LeonDebonne/TasteMate/README.md

# TasteMate
TasteMate, een slimme koelkastadd-on die het gebruiken van de koelkast vergemakkelijkt voor blinden en slechtzienden. 

🛠️ Built by ``Leon Debonne`` & ``Staf Logie``   
🔥 Supervised by ``prof. dr. Bas Baccarne``, ``Yannick Christiaens`` & ``Wouter Devriese``    
🌱 Grown at ``Ghent University`` 🏛️ ``Industrial Design Engineering`` ([project overview](https://github.com/basbaccarne/human-centered-design))       

*13/06/2026 van de laatste update*   

## Samenvatting
Het efficiënt gebruiken van de koelkast speelt een grote rol in de zelfstandigheid van blinden en slechtzienden. Op dit gebied zijn er, ondanks moderne technologieën nog veel struikelblokken die voor verwarring en frustratie kunnen zorgen. Vooral de samenwerking met zorgkrachten en huisgenoten loopt niet altijd even vlot. Zij weten niet altijd wat er uit de frigo gehaald is of wat juist is aangevuld. Ook de ordening van bepaalde producten in de frigo wordt niet altijd gerespecteerd, waardoor vaak verwarring kan ontstaan. Ten slotte is het bepalen van de houdbaarheidsdata op producten vaak niet evident. Deze problemen werden meerdere malen aangehaald in een online bevraging die verstuurd werd in verschillende Facebookgroepen voor blinden en slechtzienden.

Deze problematiek wensen we aan te pakken met een slimme koelkast-add-on. Deze dient om de samenwerking tussen de verschillende huisgenoten en zorgverleners te bevorderen. Zo kunnen producten in of uit het systeem gehaald worden en worden er vaste plaatsen toegewezen voor elk soort product. Ook worden de houdbaarheidsdata in het systeem bijgehouden. Vervolgens kan men aan een spraakassistent vragen stellen over de inhoud van de koelkast. 
Bv. “Ik heb dorst, wat kan ik drinken?” en “Zijn er producten die bijna over datum gaan?” 

<p align="center">
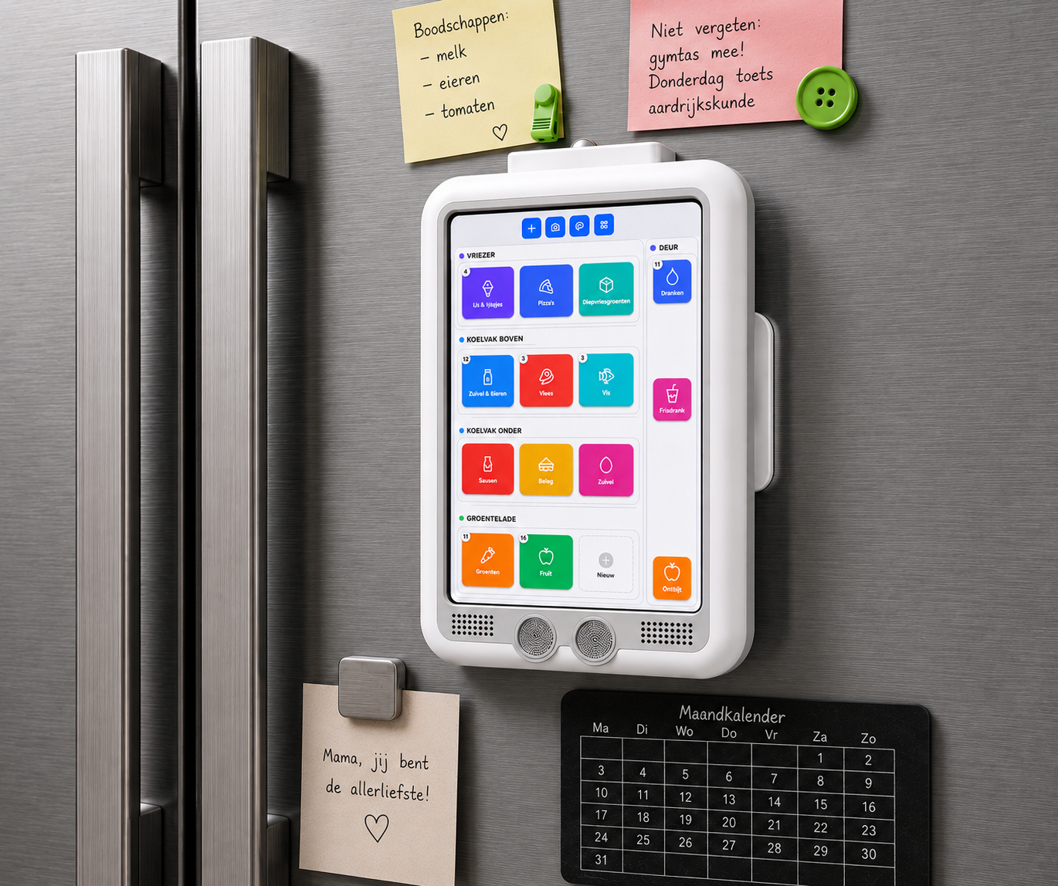
[picture p1: img/Heroshot2.png]
  
</p>

## Introductie
Het efficiënt en zelfstandig gebruiken van huishoudtoestellen is een belangrijke voorwaarde voor autonomie bij blinden en slechtzienden. Toch blijkt het dagelijks gebruik van een koelkast in gedeelde huishoudens vaak problematisch. Moeilijke toegang tot visuele informatie, zoals houdbaarheidsdata en productlabels, gecombineerd met een gebrek aan afstemming met huisgenoten of zorgverleners, leidt regelmatig tot verwarring, voedselverspilling en frustratie. Deze knelpunten kwamen ook duidelijk naar voren in een onlinebevraging binnen verschillende Facebookgroepen voor blinden en slechtzienden.

Dit project situeert zich binnen het domein van assistieve technologie en inclusieve smart home-oplossingen. Het doel is het ontwikkelen van een slimme koelkast add-on die de zelfstandigheid van blinden en slechtzienden ondersteunt en tegelijkertijd de samenwerking binnen het huishouden bevordert. De add-on maakt het mogelijk om producten te registreren, vaste plaatsen toe te wijzen en houdbaarheidsdata bij te houden. Via een spraakassistent kan de gebruiker eenvoudig informatie opvragen over de inhoud van de koelkast, zoals welke dranken beschikbaar zijn of welke producten binnenkort vervallen. Op die manier wordt de cognitieve belasting verminderd en krijgt de gebruiker meer controle over zijn of haar leefomgeving.

“Intelligent applications such as intelligent packaging, intelligent fridges and wider IoT solutions provide opportunities to reduce household food waste.” (Liegeard, J., & Manning, L. 2019)

De oplossing richt zich op zelfstandig wonende blinden en slechtzienden die ondersteund worden door een familielid of professionele begeleider. Belangrijke randvoorwaarden zijn dat het systeem betaalbaar en gebruiksvriendelijk moet zijn. De add-on fungeert nadrukkelijk als ondersteuning en niet als vervanging van menselijke zorg.

[Demonstrator Movie](https://www.youtube.com/watch?v=ily1LTjktjU)

## Inhoudstafel

1. [Methodologie](./docs/methodologie.md)
2. [Discovery](./docs/discovery.md)
3. [Definition](./docs/definition.md)
4. [Develop 1](./docs/develop_1.md)
5. [Develop 2](./docs/develop_2.md)
6. [Develop 3](./docs/develop_3.md)
7. [Conclusie](./docs/conclusie.md)
8. [Design Requirements](./docs/design_requirements.md)
9. [Bill of materials](./docs/bom.md)

## Kritische reflectie

### Semester 1

Het eerste semester stond volledig in het teken van discovery en de eerste definition van ons ontwerpproces.
We startten met een desk research en benchmarking om een beeld te krijgen van wat er vandaag al bestaat. De benchmarks hielpen ons om ons eigen idee te positioneren en niet opnieuw te ontwerpen wat al bestaat, maar eerder te kijken waar het beter of anders kon.

Daarnaast probeerden we via interviews inzicht te krijgen in de ervaringen en noden van blinde en slechtziende gebruikers. Dit bleek aanzienlijk moeilijker dan verwacht. Door hun beperkte beschikbaarheid en het feit dat we zelf weinig directe connecties hadden, was het rekruteren van respondenten een grote uitdaging. Dat was soms frustrerend en zorgde ervoor dat ons onderzoek trager verliep dan gepland.
Toch waren de interviews die we wel konden afnemen zeer waardevol. Ze bevestigden een aantal aannames, maar haalden ook zaken aan die wij zelf niet in vraag hadden gesteld. Dit maakte duidelijk hoe belangrijk het is om niet enkel vanuit eigen perspectief te ontwerpen. De input uit deze gesprekken vormde een sterke basis voor de definition fase en hielp ons om gerichtere ontwerpcriteria op te stellen.

Achteraf gezien was het eerste semester vooral een oefening in geduld en realisme. We leerden dat een goed designproces niet alleen draait om methodes doorlopen, maar ook om mensen vinden, plannen maken en omgaan met beperkingen. Positief is wel dat we intussen al enkele blinde personen hebben kunnen vastleggen voor semester 2. Dat geeft vertrouwen dat we met die mensen verder kunnen en op hun kunnen rekenen.

### Semester 2

Dit semester stond voornamelijk in het teken van de develop-fase, waarbij het concept verder werd uitgewerkt, getest en verfijnd. Tijdens Develop 1 en Develop 2 lag de focus op het realiseren van een Minimum Viable Product (MVP). Hierbij wilden we aantonen dat gebruikers op een toegankelijke manier correcte informatie uit het systeem konden opvragen, zoals de inhoud van de koelkast, houdbaarheidsdata en de locatie van producten.

Tijdens de ontwikkeling merkten we echter dat het volledig automatiseren van het invoeren en beheren van productdata veel complexer was dan oorspronkelijk verwacht. Hoewel dit conceptueel uitgebreid werd onderzocht en besproken in eerdere fases, bleek de technische realisatie binnen de beschikbare tijd en middelen niet haalbaar. Daarom werd ervoor gekozen om de nadruk te leggen op het valideren van onze MVP.

Daarnaast werd ook de volledige elektronica uitgewerkt en getest. Bij de verdere integratie in het product botsten we echter op beperkingen van de beschikbare hardware, zoals de afmetingen van het scherm. Hierdoor konden we de elektronica niet volledig verwerken in het finale prototype zoals oorspronkelijk voorzien. Om toch een realistisch beeld van het eindproduct te geven, werd een mock-up ontwikkeld waarin de vormgeving, uitstraling en CMF-keuzes duidelijk zichtbaar werden gemaakt.

De feedback die we ontvingen van de burgerlijk ingenieurs was waardevol en bracht bijkomende aandachtspunten aan het licht. Zo werd onder andere gesuggereerd om extra aandacht te besteden aan het vervangen of opladen van de batterij, aangezien dit voor blinde gebruikers een belangrijk aspect van de gebruikservaring kan zijn. Deze feedback werd pas in een latere fase van het project ontvangen, waardoor er nog beperkt ruimte was om hier grondig op verder te werken. Desondanks vormt dit een waardevol inzicht dat bij een verdere ontwikkeling van het concept zeker verder onderzocht en uitgewerkt zou worden.

Terugkijkend heeft dit semester aangetoond dat er vaak een verschil bestaat tussen een conceptuele oplossing en een technisch realiseerbaar product. Door duidelijke keuzes te maken en te focussen op de belangrijkste functionaliteiten konden we toch een concept ontwikkelen dat de meerwaarde van TasteMate aantoont en tegelijk waardevolle inzichten opleverde voor verdere ontwikkeling.

## Noot inzake het gebruik van AI
AI werd gebruikt om onze tekststructuur te verbeteren en ons taalgebruik te finetunen. Ook werd dit voor een groot deel gebruikt tijdens het coderen. Dit om te helpen op stukken waar wij vastlopen. Als laatst werd de render ook met AI gemaakt.

## Bijlagen
### Discovery
* Enquête Facebookgroepen (N=22)
  * [Protocol](https://docs.google.com/document/d/1o7BqGVpPXtm0b7tqXvRCuAdfVG6ncJB_/edit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)
  * [Rapport](https://docs.google.com/document/d/1O7acjI5cb6R5L7ywIF9YDT1ZCcgL2F2K/edit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)
* Benchmarking (N=10)
  * [Protocol](https://docs.google.com/document/d/1vpAEKPRMlF7svy2KSTlp5V-UzUufb8lO/edit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)
  * [Rapport](https://docs.google.com/document/d/19CgoGhrFplItanu5dZs29OpG1R62N-Oo/edit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)
* Interviews (N=3)
  * [Protocol](https://docs.google.com/document/d/1DkY7SQlU1YFRJ9Iaqg9hwLcdLrmlHHz3/edit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)
  * [Rapport](https://docs.google.com/document/d/1aK8kBRMgLxHuCd8vMiPDScQNG72IshPE/edit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)
    
### Definition
* User testing wave 1 (N=2)
  * [Protocol](https://docs.google.com/document/d/17SA_GU3ZMbyh3iPbD7dw8ONl4re0EuEN/edit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)
  * [Rapport](https://docs.google.com/document/d/1uVGif4huSNOTb77L3XkXnCsxwViHGHP_/edit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)
* User testing wave 2 (N=3)
  * [Protocol](https://docs.google.com/document/d/1HitaRYjg1pTKpnl82D7k5fCMe0rHJzY5/edit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)
  * [Rapport](https://docs.google.com/document/d/1aru_T9R6SH-N8Gx5HF_E67F5_VzKGTME/edit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)

### Develop 1
* Concept test bevestiging (N=3)
  * [Protocol](https://docs.google.com/document/d/e/2PACX-1vQ5ILdNGkCSPqVTiytStXOEiOJM4TjMdFCXSKQb1augADyw9BpXbAz7HJRe_mXLuvI6zYdc-TxWrjU1/pub)
  * [Rapport](https://docs.google.com/document/d/e/2PACX-1vR47XYeArb4eWIysHD9ILE3gX5S1hcfoUbw3N7H9VU58sae2Dqq3-ShSmpNV-UUnw9ESvzIbVZow18U/pub)
* Expert interviews (N=3)
  * [Protocol](https://docs.google.com/document/d/e/2PACX-1vT5qwDmTJz31Pu7O_5GgxLXhZHN01odxg5vEh5BfgYlWgnNDJRftLWxD9k230-aiaKeoALtmhIkP-6a/pub)
  * [Rapport](https://docs.google.com/document/d/e/2PACX-1vSvRK79bp2z6k5HUvx2PvZjFKIwNcD5ZVd11kHikQGJ9xtiXwY7O45dNws0hmYpW2Lt67I7f6oeh9VG/pub)

### Develop 2
* User test (N=4)
  * [Protocol](https://docs.google.com/document/d/e/2PACX-1vSZAIsG-67mNmNAeyc7hR0xE32fgY2YTjmxxFuSa4Wrfsae-_UYOLSROmIYCnQvqXG1CrvmCIasRkVt/pub)
  * [Rapport](https://docs.google.com/document/d/e/2PACX-1vSd7Mb4eXCC1kvDG9D2kJRvHZshqICP1pkpbPtWgAk5q2GEnKnOpCg0xRPsQOpQLasvUqzuRUvRHjwG/pub)

### Develop 3
* User test (N=6)
  * [Protocol](https://docs.google.com/document/d/1Du3yc0JP2OO7tfJ1TO66lZ7buom-ocno/edit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)
  * [Rapport](https://docs.google.com/document/d/1h7tK0cSN0zwXzeMT8oHGi7Mp2MEAxwit/edit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)

## Licentie 
This repository contains both software and design materials created as part of an industrial design energineering project at Ghent University.

- **Software and code:** [MIT License](./LICENSE-MIT)  
- **Design, documentation, CAD, and media:** [CC BY 4.0 License](./LICENSE)
  
You are free to reuse and build upon this work, both commercially and non-commercially, as long as proper attribution is given to the original authors.

## Bronnen
Liegeard, J., & Manning, L. (2019). Use of intelligent applications to reduce household food waste. Critical Reviews in Food Science and Nutrition, 60(6), 1048–1061.

## Bijlages
* [Figma](https://www.figma.com/board/59k548JUTl15b52AJoe5UV/TasteMate?node-id=10-61&t=lsChgVIFU8SK2wAH-1)
* [Vizcom](https://app.vizcom.com/workbench/dc0de77b-4444-438e-a90e-edc5628e1e74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)
* [Figma Interface](https://www.figma.com/make/pgeZag6MNCPOQKma9MVNmQ/Koelkast-inventaris-interface?t=HiBIRN7gsiTSVexH-1)
