LeonDebonne/TasteMate/docs/methodologie.md

## Methodologie
In dit project werd gewerkt volgens het "Triple Diamond"-ontwerpproces. Dit model bestaat uit drie hoofdfases: Discover, Define en Develop. Deze fases dienen als leidraad gedurende het project. In het eerste semester worden de eerste twee fases doorlopen.

De eerste fase is de Discover-fase en vindt plaats tijdens de eerste zes weken van het semester. In deze fase is het doel om zich te oriënteren binnen het project en een probleem te identificeren dat aansluit bij de design challenge. Dit gebeurt aanvankelijk individueel. Het probleem wordt onderzocht via verschillende methodes. Eerst wordt een literatuurstudie en benchmarking uitgevoerd, waarna op basis van deze inzichten interviews met experts worden afgenomen. Aan het einde van deze fase wordt een concept pitch gehouden, waarbij een jury beslist welke projecten verder worden uitgewerkt.

De Define-fase vindt plaats tijdens de laatste zes weken van het semester. In deze fase is het doel om het concept te valideren. Dit gebeurt door het maken van ‘quick-and-dirty’ prototypes, die worden uitgewerkt in verschillende waves. Het testen van verschillende interfaces speelt hierbij een belangrijke rol. Na meerdere iteraties van de prototypes en interfaces worden gebruikerstesten uitgevoerd, aanvankelijk in de vorm van klassieke interviews. Hierbij worden gerichte vragen gesteld over de prototypes. Op basis van deze feedback wordt verder gewerkt aan wave 2. Vervolgens worden opnieuw gebruikerstesten uitgevoerd op het aangepaste prototype, ditmaal via "Thinking aloud"-testing. Als resultaat van deze testen wordt het concept verder aangescherpt en worden mogelijke ontwerpfouten weggewerkt. Uiteindelijk ontstaat er een lijst met design requirements die als fundament dient voor de volgende fases.

Hierna volgt de Develop-fase. Deze wordt opgedeeld in drie kleinere fasen, elk met hun eigen doelstellingen. Aan het einde van de Develop-fase is het de bedoeling om tot een finaal ontwerp te komen.

In het eerste onderdeel, namelijk Develop 1, evolueert het concept naar een onderbouwde functionele architectuur. Hierbij worden verschillende structuren en modellen aangemaakt om meer inzicht in het product te verkrijgen. Daarnaast vindt een concepttest plaats om enkele ontwerpkeuzes te onderbouwen. Tot slot nemen we interviews af om de noden en eisen van de gebruiker te valideren.

Het tweede deel van de Develop-fase draait vooral rond het antropometrische aspect van het product. De usability van de gemaakte interface wordt hier ook op de proef gesteld. De gebruiker wordt opgemeten en getest op verschillende vaardigheden met de interface. Als laatste wordt de system usability scale [SUS](https://en.wikipedia.org/wiki/System_usability_scale) ingevuld.

Het derde en laatste deel van deze fase focust zich op de CMF(Color, Material, Finishes) van het product. Verder wordt het emotioneel afspect achter deze pijlers onderzocht. Door vele prototype varianten te maken en deze af te wegen ten opzicht van elkaar tijdens gebruikerstesten ontstaat er een verfijnd product. Tijdens de testen wordt het Thinking-Aloud protocol toegepast. Een hulpmiddelen tijdens deze testen is een morfologische CMF-matrix. Hiervan worden de opties beoordeelt via een evaluatievragenlijst om de voorkeuren te kwantificeren. Na deze fase kan er volop gewerkt worden aan het finale product.

Ten slotte volgt de Delivery-fase. Hierin wordt het project afgewerkt en de demonstrator movie gemonteerd.

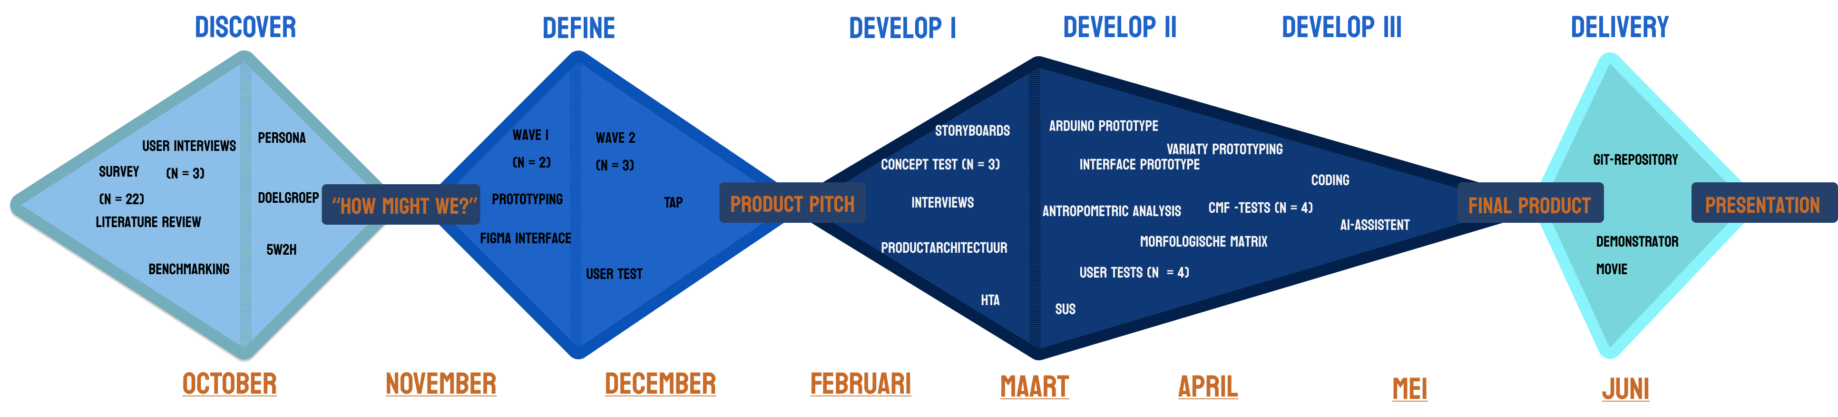
[picture p2: img/Group2.png]
TripleDiamondSem2
