LeonDebonne/TasteMate/docs/definition.md

## Definition

### Doestellingen
In deze fase van het onderzoek is het de bedoeling om van het gekozen probleem in de Discovery-fase een concreet concept te maken en dit te valideren. Het hoofddoel is het probleem beter af bakenen en dieper onderzoek voeren naar de noden en eisen van de gebruikers. Volgende onderdelen werden specifiek bestudeerd.

-	Het gebruik van de koelkast in het dagelijkse leven van een visueel beperkte persoon en de problemen in dit proces.
-	De interacties tussen het concept en de gebruiker.

### Materiaal & methoden

De definition fase begon met een sprint-dag. Hier werden enkele ontwerpeisen opgesteld als inzichten van de Discovery-fase. Uit deze eisen vloeide een storyboard die het proces van het gebruik van de koelkast met ons concept voorstelt.

<p align="center">
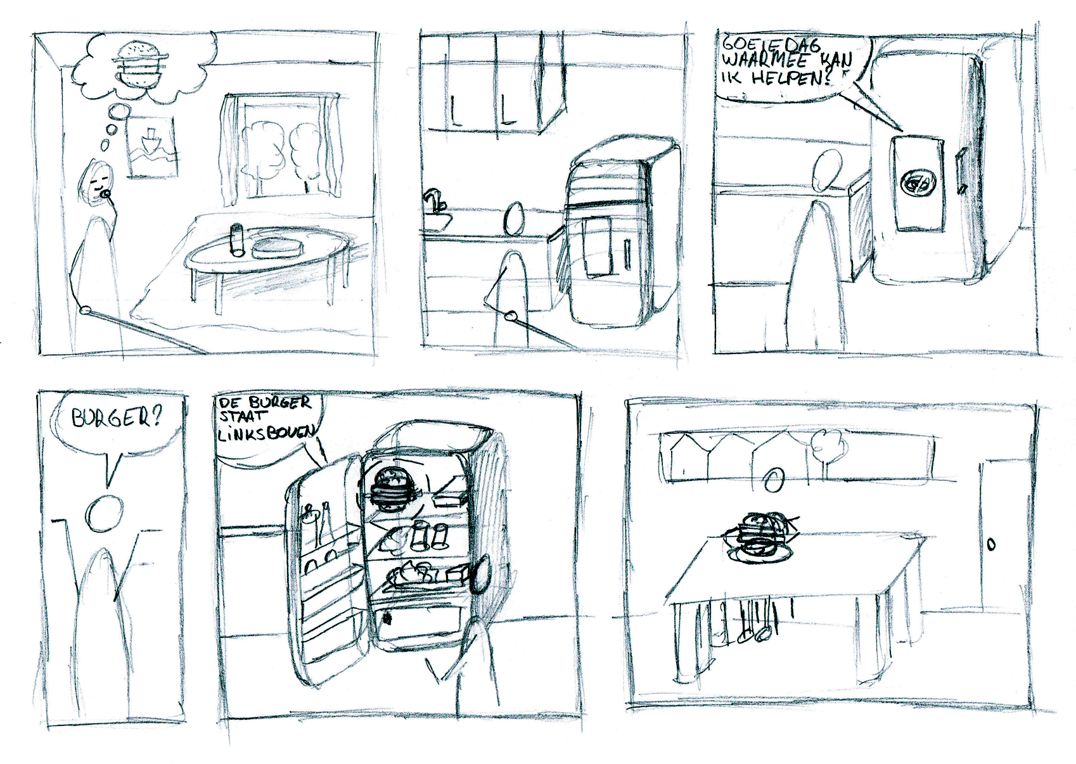
[picture p3: img/Storyboard.jpg]


Om het concept concreter te maken werd er gewerkt aan de hand van 2 prototyping waves die elke verschillende aspect onderzochten. In deze waves werden prototypes gemaakt en deze werden aan de hand van interviews en gebruikstesten beoordeeld. Op voorhand van deze testen werden er steeds protocollen opgesteld om zo gestructureerd te werk te kunnen gaan.

#### WAVE 1 
In wave 1 werd er verder onderzoek gedaan naar de vormgeving van het concept. Dit werd gedaan via 3 verschillende quick-and-dirty prototypes uit karton. Door deze prototypes voor te leggen zonder randinformatie aan visueel beperkte personen en mensen in hun omgeving werden er verschillende inzichten verworven rond de vormgeving. De prototypes werden besproken door de testpersonen via een semigestructureerd interview. Via deze manier ontstond er spontante feedback zonder filter.

<p align="center">
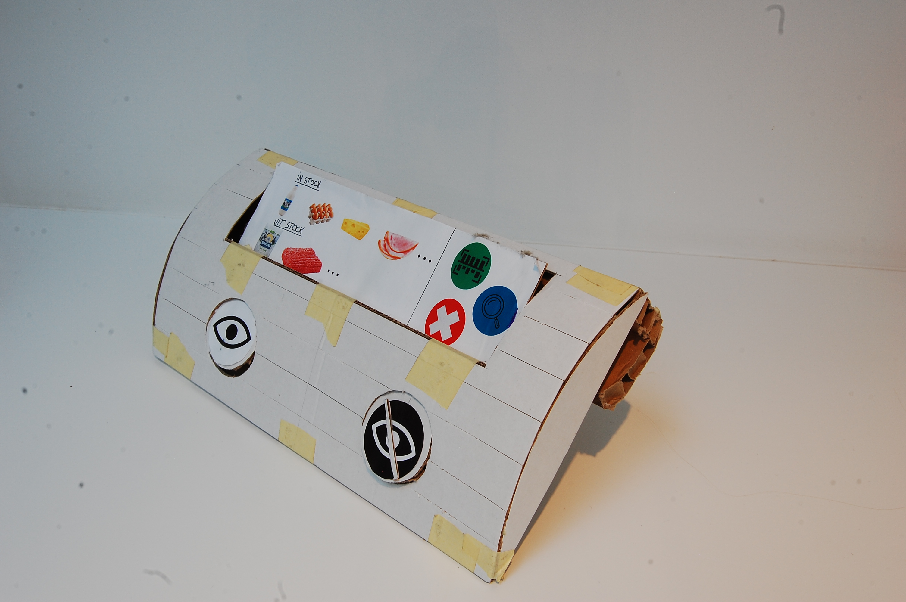
[picture p4: img/Prototype1.JPG]

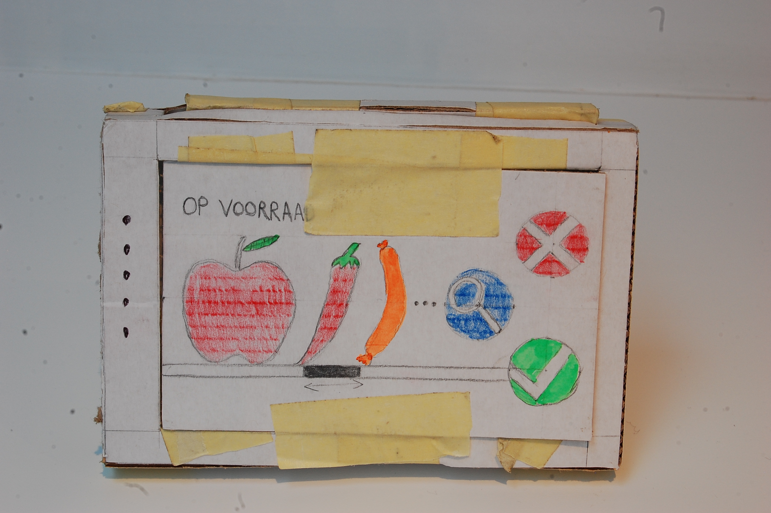
[picture p5: img/Prototype2.JPG]

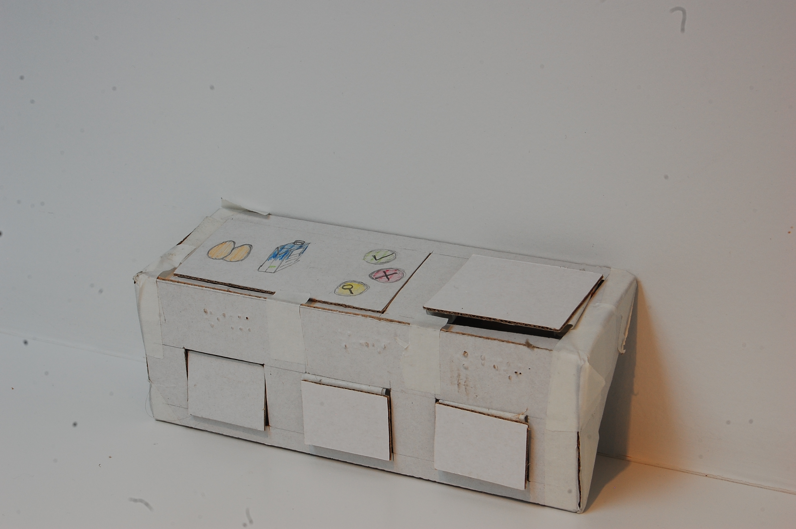
[picture p6: img/Prototype3.JPG]

</p>

De kennis en inzichten uit deze wave werden dan meegenomen om het fysiek prototype te maken voor de testen van wave 2.

#### WAVE 2
Het doel van wave 2 is om onderzoek te voeren naar de interface van het ontwerp en de functies hiervan. Om dit voorstelbaar te maken werden er twee interfaces gemaakt via FigmaMake. Door de gebruiker vrij met de prototypes te laten werken werd er gekeken hoe de doorsnee gebruiker gebruik maakt van de interface.

<p align="left">
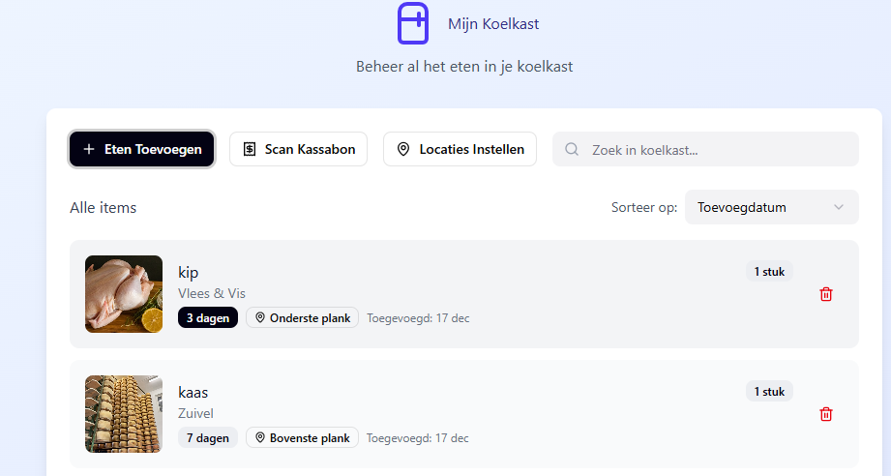
[picture p7: img/Interface1.png]

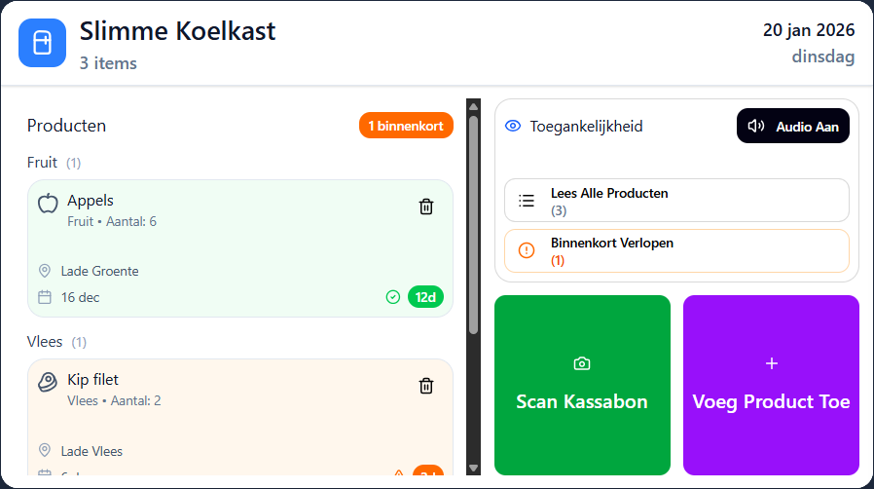
[picture p8: img/Interface2.png]

<p align="center">
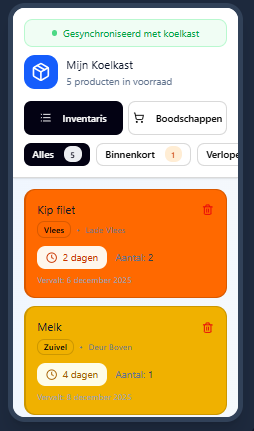
[picture p9: img/InterfaceGSM.png]

</p>

Na de testen in iedere wave werd er rapportering opgesteld om op terug te vallen tijdens volgende fases. Deze bevatten geanalyseerde feedback en observaties die samengevat worden. 

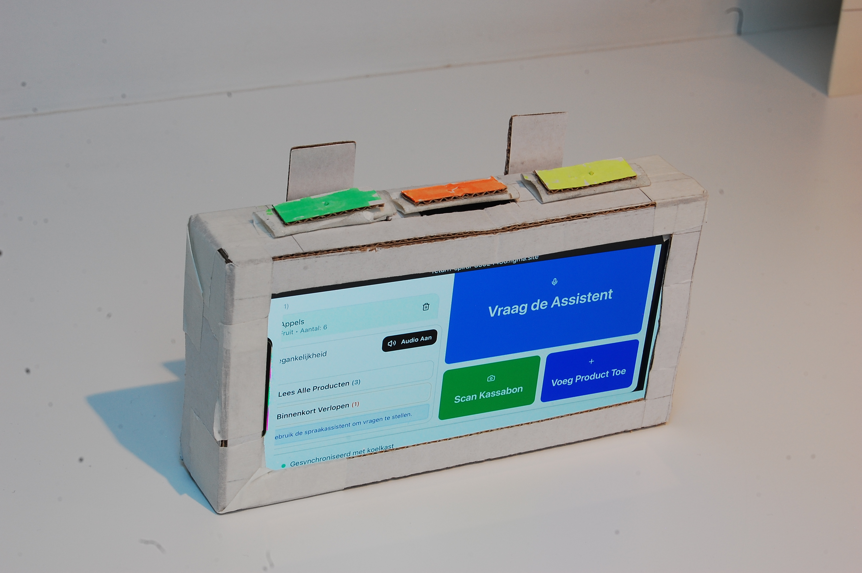
[picture p10: img/PrototypeWave2.JPG]
PrototypeWave2


### Resultaten

#### WAVE 1 (N = 2) 

De drie prototypes werden voorgelegd en besproken door onze respondenten.  Ook werd er al eens een preview getoond van de interface om ook hierrond snelle feedback te verwerven. 

**Prototype 1 :** Het eerste prototype viel vooral in de smaak door de grote hiervan. Voor visueel beperkte personen is het veel gemakkelijker om met grotere objecten te werken. De functie die het mogelijk maakt om te kiezen welke interface gebruikt wordt bleek overbodig. Beginnen spreken tegen het product of het scherm aanraken zouden eenvoudiger zijn om de interactie met het product te initiëren.

**Prototype 2 :** De vorm van het prototype werd positief ontvangen. Het feit dat het scherm kan uitklappen naast de koelkast zodat het concept kan gebruikt worden met een open en een dichte koelkast was ook een belangrijk pluspunt. Het product mocht echter wel groter. De slechtziende testpersoon vond dat het te uitdagend om vlot met het prototype te werken. Er werd wel opgemerkt dat de grootte voor blinden minder een barrière vormt. 

**Prototype 3 :**  De vorm van dit prototype was onhandig om te gebruiken doordat, de knoppen die gebruikt worden door de visueel beperkte personen aan de onderkant van de geometrie bevinden. De braille die te vinden was op deze knoppen beviel wel goed. Commentaar hierop was dat dit niet per se braille moet zijn maar, dat het tactiele van de knoppen het belangrijkste is.

<p align="left">
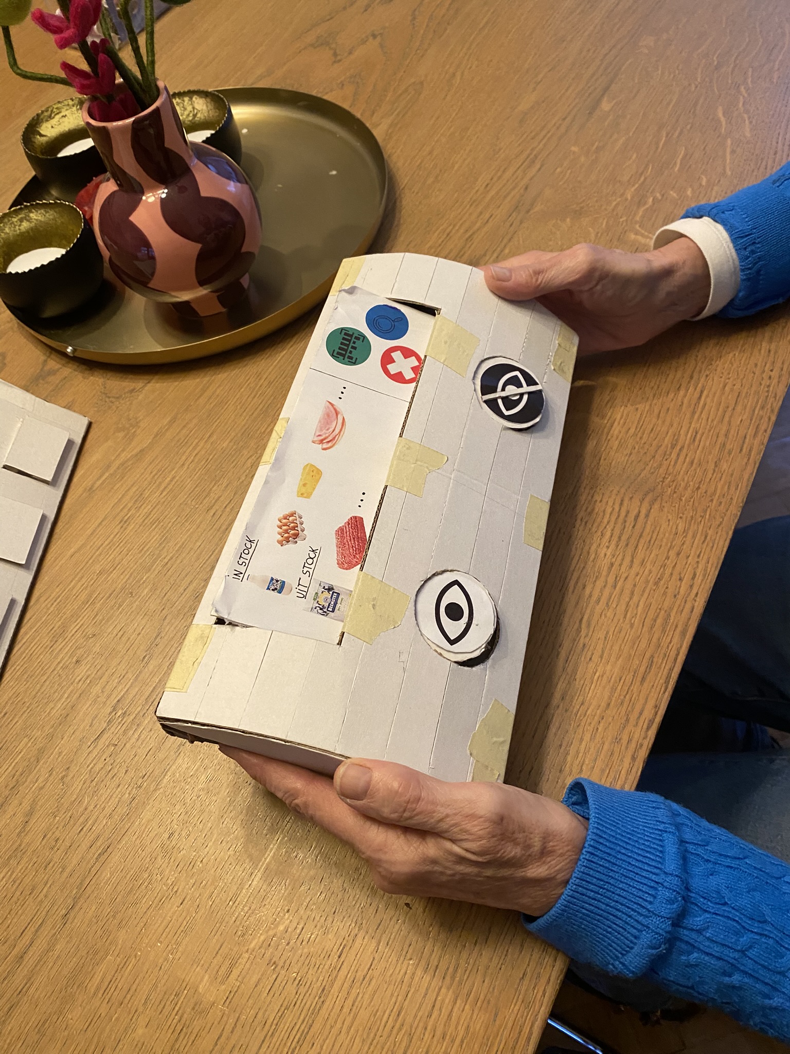
[picture p11: img/FotoPrototype2.JPEG]

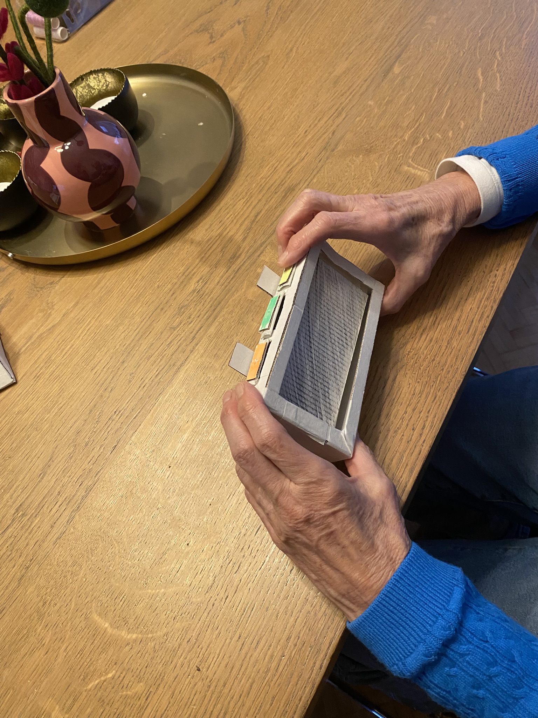
[picture p12: img/FotoPrototype3.JPEG]

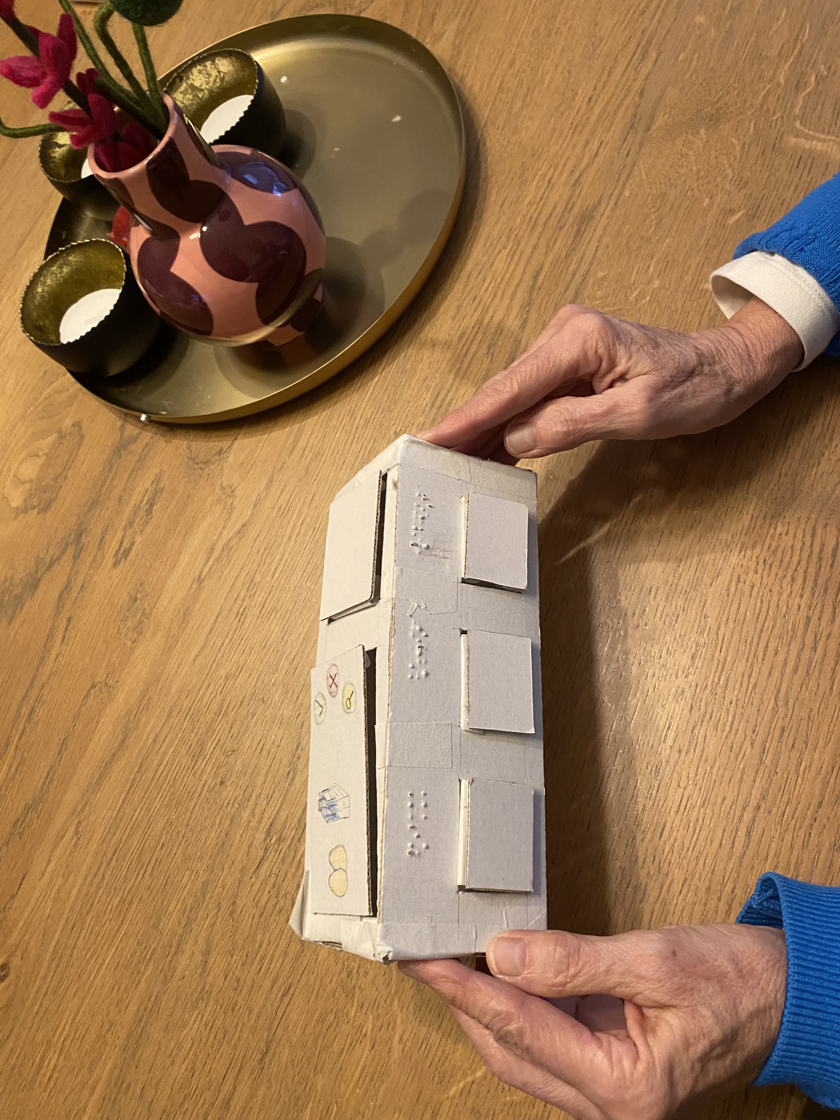
[picture p13: img/FotoPrototype1.JPEG]


Deze feedback werd geanalyseerd en in een scorematrix gegoten. Zo zijn de beste aspecten van ieder prototype bijgehouden.
<p align="center">
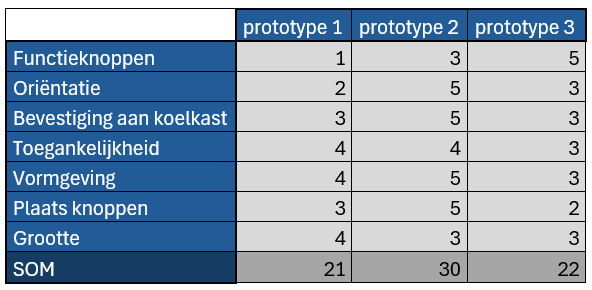
[picture p14: img/Tabel Analyse wave1.png]


Na meer duiding te geven rondom het project werd er ook op gewezen dat een app die gesynchroniseerd is met de slimme koelkast ook van pas kan komen. Het opstellen van boodschappenlijstjes voor visueel beperkte mensen is vaak een drempel. Een app die de inventaris bij houdt is praktischer. Ook is het essentieel dat het product op verschillende koelkasten past.

>[!IMPORTANT] 
> Design Requirements:
> - D2.2 Het systeem moet gebruikt kunnen worden als de koelkast geopend is, maar ook als deze gesloten is.
> - D2.6 Het ontwerp moet gebruiksvriendelijk zijn voor zowel de visueel beperkte gebruiker als huisgenoten/zorgverleners.
> - D2.8 De add-on moet compatibel zijn met bestaande koelkasten en geen ingrijpende aanpassingen vereisen.

#### WAVE 2 (N = 3):
De FigmaMake interfaces werden na een korte voorstelling van het project getest en besproken. Voor de meeste testpersonen was de werkingswijze van de interfaces intuïtief. 

**Interface 1 :** De lay-out van de interface bleek efficiënt en eenvoudig voor doorsnee gebruikers. De grootte van de tekst en functieknoppen op het scherm was te klein als slechtziende personen dit ook zouden willen gebruiken. Een functie die overbodig bleek te zijn voor visueel beperkte personen was de locatie van de voeding die werd voorgelezen door de AI -assistent doordat dit op vast locaties ligt. Bij het toevoegen van een kassabon werd er gevraagd om een pop-up toe te voegen die samenvat welke producten er gescand zijn. Zo kunnen foutieve producten gefilterd worden op voorhand.

**Interface 2 :** De interacties tussen de gebruikspersonen en de AI-assistent verliepen zeer vlot. Het kleurrijke design van de interface viel tegen volgens de testpersonen, het deed tekort aan professionaliteit. Het opzoeken van verschillende producten bleek handig om de inventaris te checken. De app die synchroon met de koelkast werkt werd goed ontvangen. Echter ontbrak een boodschappenlijstje die automatisch gemaakt werd.

>[!IMPORTANT] 
> Design Requirements:
> - D2.5 De gebruiker moet via een spraakassistent vragen kunnen stellen over de inhoud van de koelkast.
> - D2.9 Het systeem moet efficiënt de inhoud kunnen aanpassen, zodat mensen niet opgeven met het product te gebruiken.
> - D2.10 Het systeem moet helpen bij het bevorden van zelfstandig boodschappen doen.

### Conclusies & implicaties

De conclusies uit de eerste wave zijn dat het product groot genoeg moet zijn als slechtziende personen willen werken met de interface op het scherm. De functieknoppen moeten een tactiel element hebben voor snelle herkenning. Het product moet bruikbaar zijn bij een gesloten en open koelkast.

De knop voor de AI-assistent moet groot en herkenbaar zijn.
Voor wave 2 zijn de belangrijkste punten dat het niet te ingewikkeld moet. De knoppen die gebruikt worden door de visueel beperkte personen mogen niet op het scherm. Het automatisch aanmaken van een boodschappenlijst mag zeker niet ontbreken. Het moet ook mogelijk zijn op specifieke producten op te zoeken. Het scannen van een kassabon is ook een vereiste zodat het niet veel tijd kost om de inventaris aan te passen.

>[!IMPORTANT] 
> Design Requirements:
> - D2.1 Het systeem moet producten kunnen registreren wanneer deze in of uit de koelkast worden geplaatst.
> - D2.3 Het systeem moet vaste plaatsen in de koelkast kunnen toewijzen aan productcategorieën.
> - D2.4 Het systeem moet houdbaarheidsdata digitaal bijhouden en hierover tijdig feedback geven.
> - D2.7 Het product moet privacyvriendelijk omgaan met persoonlijke en huishoudelijke gegevens.

Deze conclusie werden bepaald via een MoSCoW-analyse.
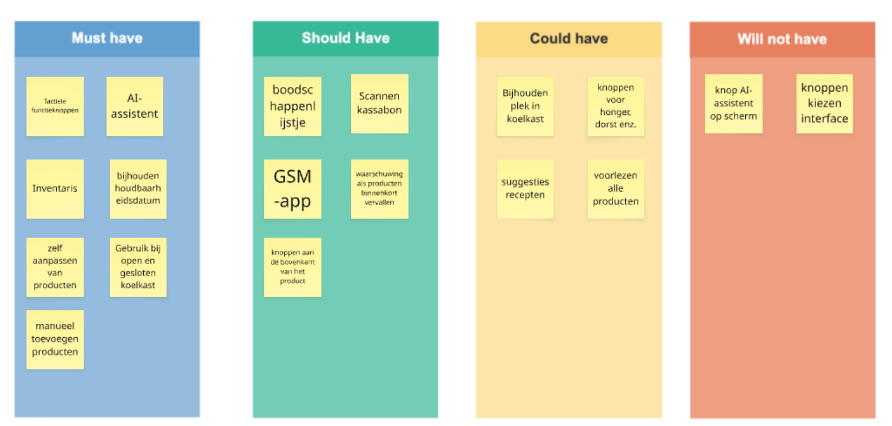
[picture p15: img/MoSCoW-analyse.png]
Moscow
