LeonDebonne/TasteMate/docs/design_requirements.md

## Overzicht van Design Requirements
|| **Status** || ❌ niet voldaan || ⚠️ gedeeltelijk voldaan || ✅ voldaan ||
|ID|Design Requirement|Source|Status|
|:---|:---|:---|:---:|
|**Discover**|
|1.1|De oplossing ondersteunt de zelfstandigheid van blinden en slechtzienden bij het dagelijks gebruik van de koelkast.|[Discovery](discovery.md)|✅|
|1.2|De oplossing minimaliseert verwarring en frustratie bij wijzigingen in de koelkastinhoud door derden.|[Discovery](discovery.md)|✅|
|1.3|De oplossing faciliteert samenwerking en communicatie tussen de gebruiker, huisgenoten en zorgverleners.|[Discovery](discovery.md)|✅|
|1.4|De oplossing biedt een actueel overzicht van de aanwezige producten in de koelkast.|[Discovery](discovery.md)|✅|
|1.5|De oplossing biedt toegankelijke en betrouwbare informatie over houdbaarheidsdata.|[Discovery](discovery.md)|✅|
|1.6|De interactie verloopt primair auditief en intuïtief, waardoor visuele input optioneel is.|[Discovery](discovery.md)|✅|
|1.7|De oplossing is laagdrempelig en bruikbaar zonder complexe handelingen of technische voorkennis.|[Discovery](discovery.md)|✅|
|1.8|De oplossing fungeert als ondersteuning en bevordert de bestaande zorgverlening.|[Discovery](discovery.md)|✅|
|1.9|Het product is financieel toegankelijk voor thuisgebruik.|[Discovery](discovery.md)|❌
|**Definition**|
|2.1|Het systeem registreert producten bij het plaatsen in of uitnemen uit de koelkast.|[Definition Wave 1&2](definition.md)|✅|
|2.2|Het systeem is functioneel bij zowel een geopende als gesloten koelkastdeur.|[Definition Wave 2](definition.md)|✅|
|2.3|Het systeem wijst vaste locaties in de koelkast toe aan specifieke productcategorieën.|[Definition Wave 2](definition.md)|✅|
|2.4|Het systeem monitort houdbaarheidsdata digitaal en geeft tijdige feedback.|[Definition Wave 1](definition.md)|✅|
|2.5|De koelkastinhoud is opvraagbaar via een spraakassistent.|[Definition Wave 1&2](definition.md)|✅|
|2.6|Het ontwerp is gebruiksvriendelijk voor zowel visueel beperkte gebruikers als huisgenoten en zorgverleners.|[Definition Wave 1&2](definition.md)|✅|
|2.7|Het product waarborgt de privacy van persoonlijke en huishoudelijke gegevens.|[Definition Wave 2](definition.md)|✅|
|2.8|De add-on is compatibel met bestaande koelkasten zonder ingrijpende aanpassingen.|[Definition Wave 1](definition.md)|✅||
|2.9|Het systeem staat een efficiënte aanpassing van de inhoud toe om de gebruikersretentie te maximaliseren.|[Definition Wave 2](definition.md)|✅|
|2.10|Het systeem bevordert de zelfstandigheid bij het doen van boodschappen.|[Definition Wave 2](definition.md)|⚠️|
|**Develop 1**|
|3.1|Het systeem laat toe kleurencontrast aan te passen naar persoonlijke voorkeur gebruiker.|[Develop 1](develop_1.md)|✅|
|3.2|Het systeem is bruikbaar met courante schermleessoftware.|[Develop 1](develop_1.md)|❌|
|**Develop 2**|
|4.1| Het product volgt het principe voor design for adjustability|[Develop 2](develop_2.md)|✅|
|4.2| Kritieke acties (zoals verwijderen) vereisen een duidelijke maar niet storende bevestiging om fouten te vermijden. |[Develop 2](develop_2.md)|✅|
|4.3| Het systeem vereist minimale fysieke inspanning bij het aanpassen van positie (lage weerstand, intuïtieve scharnieren). |[Develop 2](develop_2.md)|✅|
|4.4| Alle iconen op de interface zijn eenduidig en semantisch herkenbaar zonder uitleg. |[Develop 2](develop_2.md)|✅|
|4.5| Het systeem bevat consistentie en visuele hiërarchie volgens Gestalt-principes. |[Develop 2](develop_2.md)|✅|
|4.6| Navigatie door het systeem vereist geen voorafgaande training of uitleg. |[Develop 2](develop_2.md)|✅|
|4.7| De interface moet een SUS-score > 80 behalen. |[Develop 2](develop_2.md)|✅|
|**Develop 3**|
|5.1|De behuizing is vervaardigd uit kwaliteitsvolle kunststof met voldoende wanddikte om een gevoel van stevigheid en duurzaamheid te geven.|[Develop 3](develop_3.md)|✅|
|5.2|Het product heeft een neutraal kleurenpalet (bij voorkeur zwart of wit) om te integreren in diverse keukenomgevingen zonder de aandacht te trekken.|[Develop 3](develop_3.md)|✅|
|5.3|De afwerking is mat om lichtreflectie te vermijden en rust en professionaliteit uit te stralen.|[Develop 3](develop_3.md)|✅|
|5.4|De behuizing heeft afgeronde hoeken voor een moderne en kwaliteitsvolle esthetiek.|[Develop 3](develop_3.md)|✅|
|5.5|Het tactiele knopelement is groot en duidelijk herkenbaar zonder visuele controle.|[Develop 3](develop_3.md)|✅|
|5.6|Het product vermijdt textuur of opvallende oppervlaktedetails die de aandacht afleiden of storend kunnen zijn voor visueel beperkte gebruikers.|[Develop 3](develop_3.md)|✅|
