LeonDebonne/TasteMate/docs/develop_3.md

## Develop 3

In deze deelopdracht wordt gefocust op de CMF-analyse (Colour, Material & Finish) van het product. Aan de hand van gebruikstesten met verschillende prototypevarianten worden ontwerpbeslissingen gevalideerd op vlak van kleur, materiaal en afwerking. De resultaten van deze testen vormen de basis voor het vastleggen van de definitieve CMF-keuzes van het product.

### Doelstellingen

Het hoofddoel van deze deelopdracht is het evalueren en valideren van de CMF-keuzes aan de hand van gebruikersfeedback. Hiervoor worden meerdere prototypevarianten getest en onderling vergeleken om inzicht te verkrijgen in de esthetische en materiële voorkeuren van de doelgroep.

De doelstellingen van deze deelopdracht zijn:
- Het valideren van de CMF-keuzes op basis van gebruikersvoorkeuren
- Het identificeren van kleur-, materiaal- en afwerkingscombinaties die het best aansluiten bij de verwachtingen van de gebruiker
- Het onderzoeken van mogelijke patronen in gebruikersvoorkeuren op basis van contextfactoren, zoals woonomgeving of huiselijke samenstelling

### Materialen & methoden
Het CMF onderzoek is gestart vanuit enkele referentiefoto's om een eerste beeld te krijgen van naar welke stijl gestreefd wordt.
<p align="center">
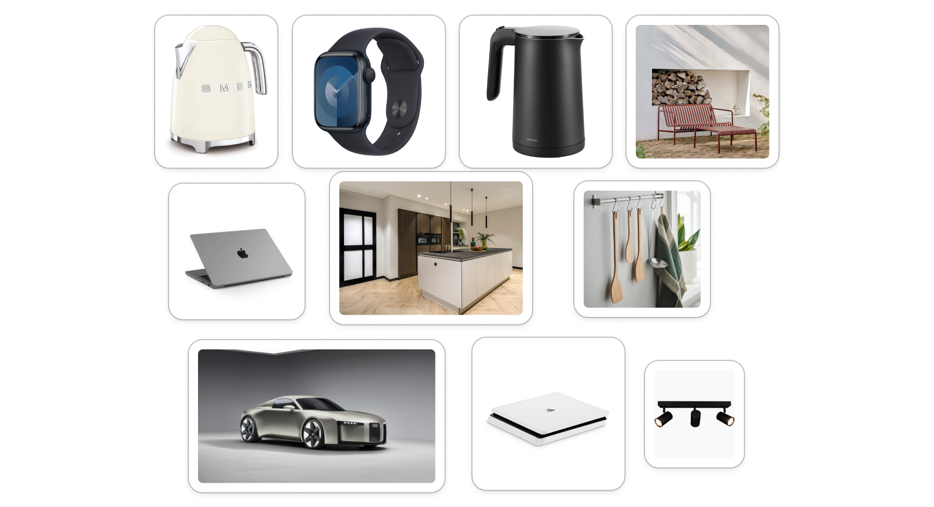
[picture p17: img/Referenties.png]
    
</p>
Deze referenties zijn gezocht met enkele kernwoorden in het achterhoofd namelijk; zintuigelijk, minimalistisch, afgerond, verfijnd en neutraal.
</p>
Voor deze fase werden prototypevarianten ontwikkeld die onderling verschillen op het vlak van vorm, materiaal en afwerking. De respondenten vormen een gevarieerde steekproef wat betreft leeftijd, achtergrond en vertrouwdheid met het producttype. Er wordt gestreefd naar een evenwichtige verdeling van geslacht en leeftijdscategorie.

Na een korte inleiding waarbij het project wordt toegelicht. Krijgt de testpersoon de tijd om de prototypevarianten rustig te bekijken en de materialen te voelen. Hierbij wordt gepeild naar de eerste indruk: welke variant trekt meteen de aandacht en welke spreekt het minste aan.

De fysieke prototypes bestaan uit drie componenten:
- **Behuizingsvorm** (3 varianten): van vierkant met scherpe randen tot sterk afgerond, geprint in zwart kunststof.
- **Knopelementen** (6 varianten): verschillende tactiele vormen zoals een kleine bol, golven, bolletjesrij, zigzag, boog en een donut-vorm.
- **Materiaalstalen** (4 varianten): MDF, sheetmetal, multiplex en zwart kunststof.

<p align="center">
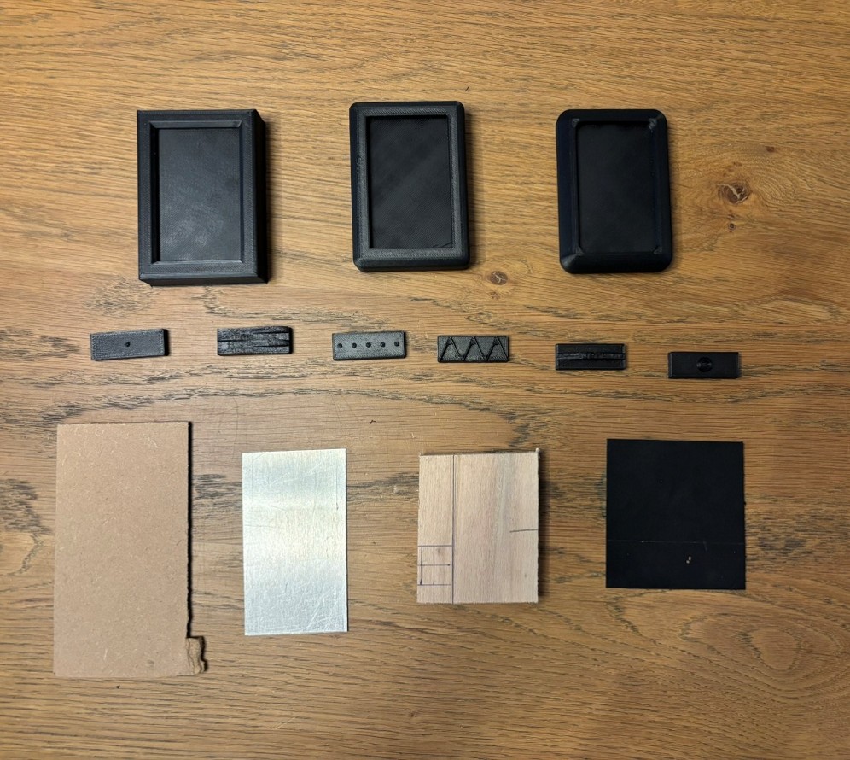
[picture p18: img/CMF_opties.jpg]


Vervolgens wordt via het Thinking Aloud Protocol (TAP) elke variant afzonderlijk en in detail besproken op vlak van kleur, materiaal en afwerking. De testpersoon denkt luidop en gaat dieper in op de beleving bij elk CMF-aspect. Zo wordt bijvoorbeeld gevraagd of de kleur passend aanvoelt bij de context van het product, of het materiaal een gevoel van kwaliteit en duurzaamheid uitstraalt, en of de afwerking hygiënisch en onderhoudsvriendelijk oogt.

Voor het exploreren van verschillende CMF-iteraties werden digitale conceptvarianten gegenereerd met behulp van [Vizcom](https://app.vizcom.com/workbench/dc0de77b-4444-438e-a90e-edc5628e1e74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). Deze tool maakte het mogelijk om snel uiteenlopende combinaties van kleur, materiaal en afwerking te visualiseren en onderling te vergelijken. Op basis van deze gegenereerde varianten werd het uiteindelijke CMF-board samengesteld met de meest relevante en veelbelovende opties voor gebruikerstesten.

De testpersoon rangschikt de varianten per CMF-categorie en stelt zelf gewenste combinaties samen op het CMF-board, waarbij elementen van verschillende varianten vrij gecombineerd kunnen worden.

<p align="center">
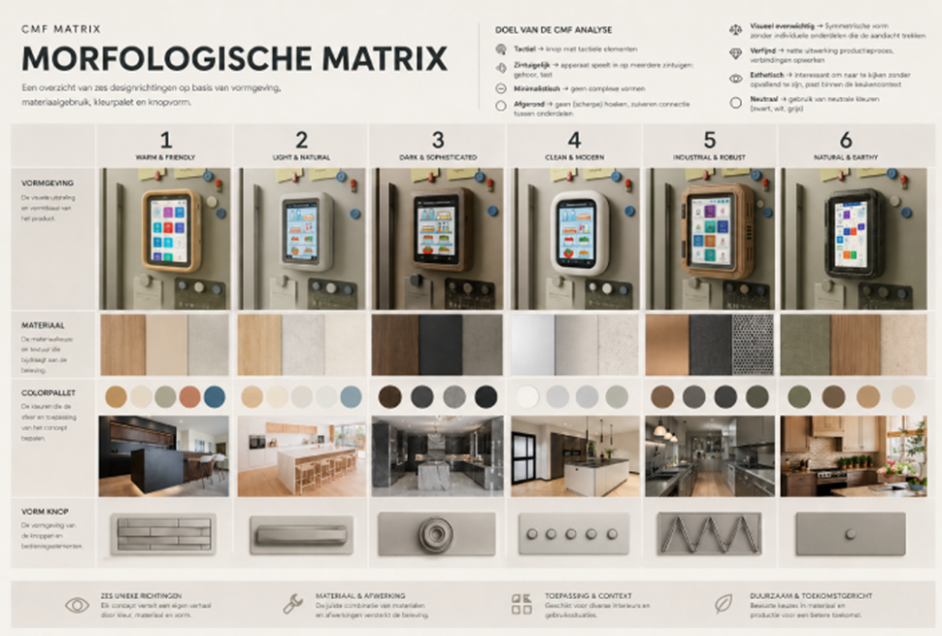
[picture p19: img/CMF-board.png]


De test wordt afgesloten met een korte evaluatievragenlijst waarbij elke variant beoordeeld wordt op vormgeving, materiaal, kleurenpalet, knopvorm en algemene voorkeur op een schaal van 1 tot 5.

| **Criterium** | **Nr.1** | **Nr.2** | **Nr.3** | **Nr.4** | **Nr.5** | **Nr.6** |
| --- | --- | --- | --- | --- | --- | --- |
| Vormgeving (1–5) | | | | | | |
| Materiaal (1–5) | | | | | | |
| Kleurenpalet (1–5) | | | | | | |
| Vorm knop (1–5) | | | | | | |
| Algemene voorkeur (1–5) | | | | | | |

### Resultaten

#### User tests

**Kleur:**
De testpersonen gaven duidelijk de voorkeur aan neutrale kleuren zoals zwart en wit. Het product mag de aandacht in de keuken niet afleiden. De focus moet hier elders liggen, zoals op bloemen of andere decoratieve elementen. Felle kleuren werden hierdoor afgeraden. De gewenste kleur moet rust en professionaliteit uitstralen, zodat het product een premium en verfijnde esthetiek uitdraagt zonder opzichtig te zijn. Enkele gebruikers merkten op dat de kleur idealiter aansluit bij de koelkast zelf of de kast waarin deze is ingebouwd. Gezien de grote variëteit aan koelkastkleuren wordt dit echter als moeilijk haalbaar beschouwd, wat het gebruik van neutrale kleuren nogmaals bevestigt.

**Materiaal:**
Kunststof werd als eerste benoemd bij het materiaal, mits dit kwaliteitsvol is en niet te licht aanvoelt. Lichte producten worden geassocieerd met een goedkoop gevoel en breekbaarheid; de wanddikte is dus een bepalende factor. Het materiaal moet warm aanvoelen om een gevoel van kwaliteit en duurzaamheid over te brengen. Hout werd minder positief ontvangen omdat het niet past bij de esthetiek en het gevoel van een koelkast, al kan het bij andere keukenelementen passen. Metaal werd door sommigen als optie gezien omdat koelkasten er vaak uit gemaakt zijn, maar de glans ervan trekt te veel de aandacht en geeft een gevoel van een zwaar object.

**Afwerking:**
De voorkeur voor afwerking was unaniem: iedereen koos voor een matte afwerking. Dit straalt rust en professionaliteit uit. Glanzende afwerking werd afgeraden omdat lichtreflectie als ongewenst werd ervaren. Textuur toevoegen aan het oppervlak werd evenmin gewenst, omdat dit het product meer doet opvallen en afleidend kan werken, ook voor visueel beperkte gebruikers.

**Prototypes:**
De behuizingsvorm met de sterkste afronding scoorde het best: de afronding geeft een rustige en moderne uitstraling die als kwaliteitsvol werd ervaren. De middelste optie werd als goed beschouwd, maar de afronding mocht groter zijn. De rechthoekige variant met scherpe randen werd vergeleken met een schilderijkader en geassocieerd met saai en ouderwets.

Bij de knopelementen werd de rangschikking bepaald op basis van het tactiele element. De kleine bol was te klein om snel te vinden. De golvende vorm gaf niet het gevoel van een knop. De rij bolletjes was beter maar bleef te klein. Het zigzaggende element was te complex. De grote boog was herkenbaar maar te glad om over te glijden. De donut met afgeronde randen werd als beste beoordeeld: groot, herkenbaar en goed voelbaar met de vingers. Hieruit volgt dat een groot, tactiel herkenbaar element de voorkeur geniet.

De beslissingsmatrix werd gemiddeld als volgt ingevuld:

| **Criterium** | **Nr.1** | **Nr.2** | **Nr.3** | **Nr.4** | **Nr.5** | **Nr.6** |
| --- | --- | --- | --- | --- | --- | --- |
| Vormgeving (1–5) | 4 | **5** | 3 | 5 | 1 | 2 |
| Materiaal (1–5) | **5** | 4 | 4 | 5 | 1 | 2 |
| Kleurenpalet (1–5) | **5** | 4 | 3 | 2 | 1 | 1 |
| Vorm knop (1–5) | 2 | 4 | **5** | 3 | 3 | 1 |
| Algemene voorkeur (1–5) | 4 | 4 | 4 | 3 | 2 | 1 |

Drie ontwerpen komen op gelijk hoogte. Wanneer de knopvorm buiten beschouwing wordt gelaten, scoort ontwerp 1 het best. Er zijn echter nog betere combinaties mogelijk door elementen uit meerdere varianten te combineren, zoals ook op het CMF-board werd aangeduid.

**Referentiemerken:**
De door de gebruikers genoemde referentiemerken waren Bang & Olufsen, Sonos, Philips, Apple en HP. Een bijkomende CMF-analyse van deze merken bevestigde de bevindingen uit de testen: neutrale en beperkte kleurpaletten domineren bij premium merken, kunststof is het meest voorkomende materiaal, en matte afwerkingen worden door het volledige spectrum gebruikt, zij het om uiteenlopende redenen, van ambachtelijk keurmerk tot praktische keuze.

<p align="center">
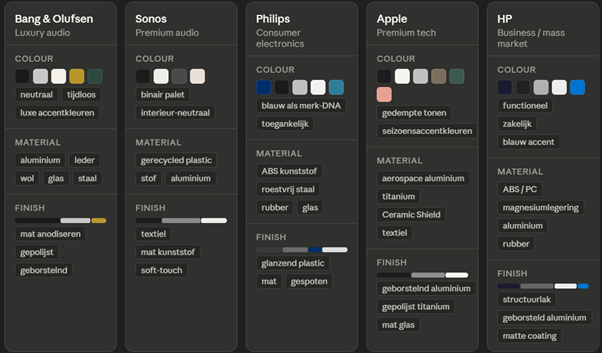
[picture p20: img/referentiemerken.png]


<p align="center">
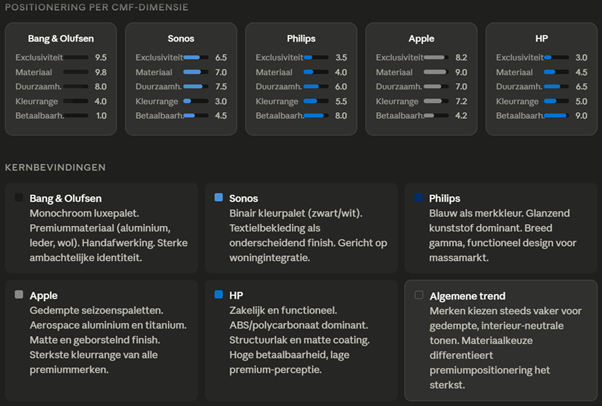
[picture p21: img/kernverbindingen.png]


### Conclusies & implicaties

De resultaten tonen een duidelijke en consistente voorkeur voor een rustig, professioneel en functioneel CMF-profiel. Gebruikers verwachten een kunststoffen behuizing die warm aanvoelt en kwaliteit uitstraalt, in een neutraal kleurenpalet (zwart of wit) en met een matte afwerking. De afgeronde behuizingsvorm en een groot, tactiel herkenbaar knopelement sluiten het best aan bij de verwachtingen van de gebruikers.

De doelstellingen werden grotendeels behaald: er is een duidelijke meerderheidsfavoriet op vlak van materiaal en afwerking, en de voorkeuren voor kleur vertonen een consistent patroon over alle testpersonen heen. De analyse van referentiemerken bevestigt bovendien de richting die de gebruikers aanduiden.

Op basis van deze bevindingen kunnen de definitieve CMF-keuzes worden vastgelegd. Enkele verfijningen, zoals de exacte knopvorm en de precieze kleurspecificaties, kunnen in een volgende iteratie verder worden uitgewerkt op basis van materiaalstalen en kleurproeven.

> [!IMPORTANT]
> Design Requirements:
> - D5.1 De behuizing is vervaardigd uit kwaliteitsvolle kunststof met voldoende wanddikte om een gevoel van stevigheid en duurzaamheid te geven.
> - D5.2 Het product heeft een neutraal kleurenpalet (bij voorkeur zwart of wit) om te integreren in diverse keukenomgevingen zonder de aandacht te trekken.
> - D5.3 De afwerking is mat om lichtreflectie te vermijden en rust en professionaliteit uit te stralen.
> - D5.4 De behuizing heeft afgeronde hoeken voor een moderne en kwaliteitsvolle esthetiek.
> - D5.5 Het tactiele knopelement is groot en duidelijk herkenbaar zonder visuele controle.
> - D5.6 Het product vermijdt textuur of opvallende oppervlaktedetails die de aandacht afleiden of storend kunnen zijn voor visueel beperkte gebruikers.
