LeonDebonne/TasteMate/docs/conclusie.md

# Conclusie

TasteMate werd ontwikkeld als antwoord op de uitdagingen die blinde en slechtziende personen ervaren bij het beheren van de inhoud van hun koelkast. Uit de discovery-fase bleek dat gebruikers vaak moeilijk toegang hebben tot informatie over beschikbare producten en houdbaarheidsdata, terwijl wijzigingen door huisgenoten of begeleiders regelmatig voor verwarring zorgen. Deze inzichten vormden de basis voor de opgestelde Design Requirements en stuurden het verdere ontwerpproces.

Het finale concept bestaat uit een slimme koelkast add-on die gebruikers ondersteunt bij het opvragen van informatie over producten in de koelkast. Via een auditieve interactie kunnen gebruikers onder andere nagaan welke producten aanwezig zijn, waar deze zich bevinden en welke producten binnenkort vervallen. Door producten te koppelen aan vaste locaties en informatie op een toegankelijke manier beschikbaar te maken, wil TasteMate de zelfstandigheid van de gebruiker vergroten en onzekerheid bij dagelijkse handelingen verminderen.

Tijdens de definition- en develop-fase werd het concept iteratief uitgewerkt en afgetoetst aan de vooropgestelde ontwerpvereisten. Het concept ondersteunt de gebruiker bij het behouden van een actueel overzicht van producten (DR 1.4), maakt houdbaarheidsinformatie toegankelijk (DR 1.5) en faciliteert de communicatie tussen gebruikers en huisgenoten (DR 1.3). Daarnaast staat een intuïtieve en primair auditieve interactie centraal (DR 1.6), zodat het systeem bruikbaar blijft zonder uitgebreide technische voorkennis (DR 1.7). Door deze combinatie van functionaliteiten sluit TasteMate nauw aan bij de behoeften die tijdens het gebruikersonderzoek naar voren kwamen.

De validatie van het Minimum Viable Product toonde aan dat gebruikers op een toegankelijke manier informatie uit het systeem konden opvragen. Bovendien behaalde het concept een gemiddelde SUS-score van 81,75%, waarmee de vooropgestelde usability goal van minimaal 80% werd bereikt. De gebruikerstesten bevestigden dat de kernfunctionaliteiten intuïtief waren en dat gebruikers relatief snel hun weg vonden binnen het systeem.

Hoewel bepaalde technische aspecten, zoals het automatisch registreren en beheren van productdata, buiten de technische haalbaarheid van dit project vielen, geloven we dat TasteMate een sterke en geloofwaardige oplossing biedt voor het oorspronkelijke probleem indien dit technisch nog uitgebreider wordt. Het concept combineert toegankelijkheid, zelfstandigheid en communicatie binnen één systeem en vormt daardoor een waardevolle ondersteuning voor blinde en slechtziende personen bij het beheren van hun koelkastinhoud.

<p align="center">
  
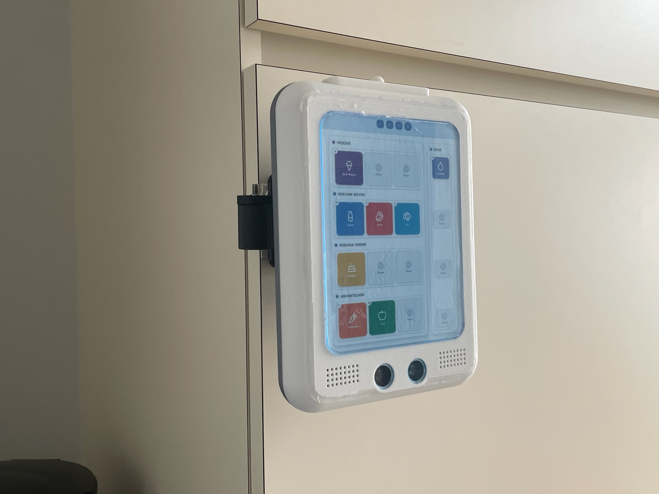
[picture p41: img/Mockup2.jpg]
  
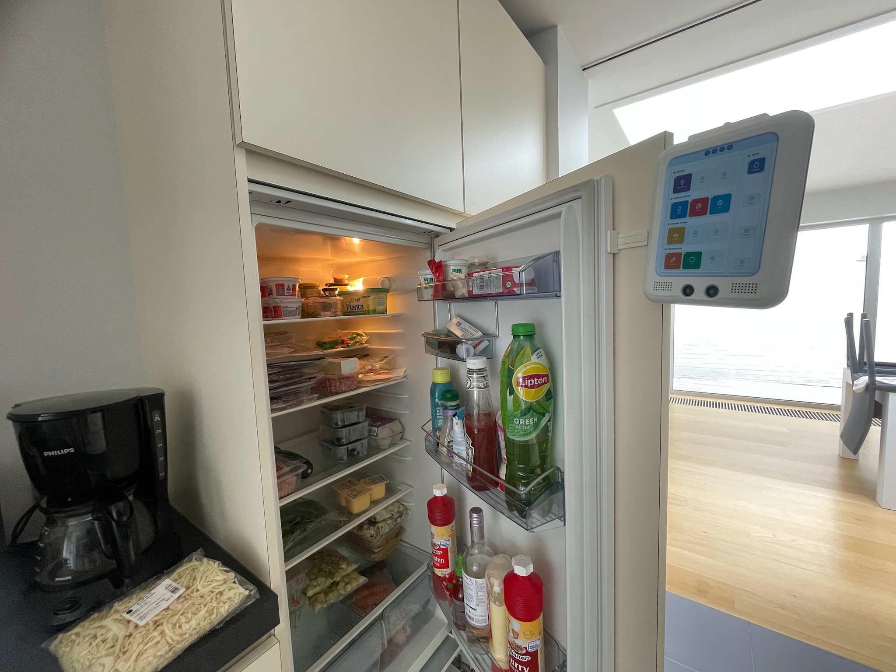
[picture p42: img/Mockup1.jpg]
  
</p>
