LeonDebonne/TasteMate/docs/discovery.md

## Discovery
De Discovery-fase werd opgesplitst in 2 verschillende fases. De eerste fase was het scopen van onze challenge en een gepast "how might we" opstellen. Vervolgens gaan we verder met die "how might we" en voeren we hier verder onderzoek naar uit.   

### Doestellingen fase 1
De doelstelling in de eerste fase is het opstellen van een relevante "how might we" die binnen onze challenge valt. Hier zoeken we vooral naar een "how might we" die niet voor de hand ligt, maar die wel een grote impact heeft op de levens van blinden en slechtzienden.
### Materiaal & methoden fase 1
**1. Interviews (N=3):**
De interviews werden afgenomen bij blinde en slechtziende personen van verschillende leeftijden en met uiteenlopende gradaties van visuele beperking. De gesprekken waren semigestructureerd, zodat er ruimte was voor zowel gerichte vragen als persoonlijke verhalen en ervaringen. Hier verwijzen we graag naar ons interviewprotocol die ook in het verslag staat.

**2. Enquête (N=22):**
De enquête werd verstuurd in verschillende Facebook groepen: “Blinden en slechtzienden”, “Hulpmiddelen en tips voor blinden en slechtzienden” en “Blinde en slechtziende lotgenoten”. Zowel mannen als vrouwen namen deel van allerlei verschillende leeftijden. Er hebben in totaal 22 mensen de enquête ingevuld.

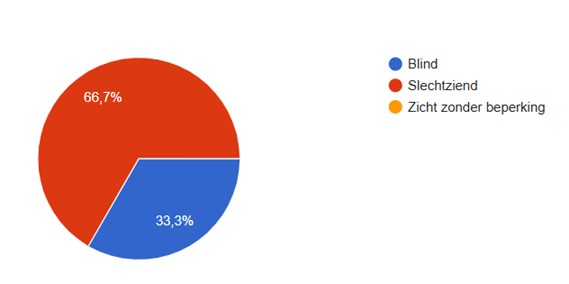
[picture p43: img/Grafiek_Enquête.jpg]
Grafiek1


**3. Benchmarking:**
In deze benchmark werd onderzocht welke bestaande hulpmiddelen er zijn voor blinden en slechtzienden en hoe deze gebruikmaken van technologie zoals sensoren, spraak, trillingen en navigatie. De focus lag op gebruiksgemak, mate van zelfstandigheid die ze bieden, en de toegankelijkheid in prijs en doelgroep. Het doel was inzicht krijgen in bestaande oplossingen en mogelijke kansen voor nieuwe, toegankelijkere systemen.

### Resultaten fase 1
#### 1. Interviews (N=3)

Blinde en slechtziende personen vertrouwen sterk op structuur. Herkenbare plekken maken zelfstandigheid mogelijk, terwijl onverwachte veranderingen verwarring veroorzaken. Oriëntatie in openbare ruimtes blijft moeilijk en bestaande hulpmiddelen bieden niet altijd volledige betrouwbaarheid. Thuis veroorzaken verplaatste spullen en gebrekkige communicatie praktische problemen en stress, waardoor gebruikers hun omgeving liefst zelf organiseren. Toegankelijke informatie via spraak, braille en tastbare signalen zijn belangrijk. Geïntegreerde oplossingen worden boven opvallende hulpmiddelen verkozen. Veel dagelijkse taken vragen extra mentale inspanning.

>[!IMPORTANT] 
> Design Requirements:
> - D1.1 De oplossing moet de zelfstandigheid van blinden en slechtzienden in het dagelijks gebruik van de koelkast ondersteunen.

#### 2. Enquête (N = 22)

Blinde en slechtziende personen vertrouwen vooral op de taststok, smartphones met gespecialiseerde apps en hulpmiddelen zoals loepen, braille-apparaten of spraaklabels voor navigatie en herkenning van voorwerpen. Oriëntatie in nieuwe omgevingen blijft uitdagend door de onvoorspelbaarheid. Thuis ontstaan vaak problemen bij het terugvinden van voorwerpen, vooral in de koelkast en bij kleding, waarvoor structuur helpt. Ongeveer de helft functioneert zelfstandig, de andere helft krijgt regelmatig hulp.

>[!IMPORTANT] 
> Design Requirements:
> - D1.2 De oplossing moet verwarring en frustratie verminderen die ontstaan door veranderingen in de koelkastinhoud door huisgenoten of zorgverleners.
> - D1.4 De oplossing moet het overzicht over aanwezige producten in de koelkast verbeteren.
> - D1.7 De oplossing moet laagdrempelig zijn en geen complexe handelingen of technische kennis vereisen.

#### 3. Benchmarking (N=10)

De benchmarkanalyse onderzocht technologische hulpmiddelen voor blinde en slechtziende personen. Veel producten gebruiken sensoren, spraak, trillingen en AI om obstakels te detecteren. Apps zoals EMVI bieden ondersteuning bij herkenning van voorwerpen en lezen van teksten, terwijl apparaten zoals WeWalk navigatie en oriëntatie verbeteren. Sommige, zoals Lumen Glasses, zijn zeer prijzig anderen, zoals Hoople zijn betaalbaar en robuust. Het aanbod varieert van eenvoudige tactiele oplossingen tot complexe hightech systemen.

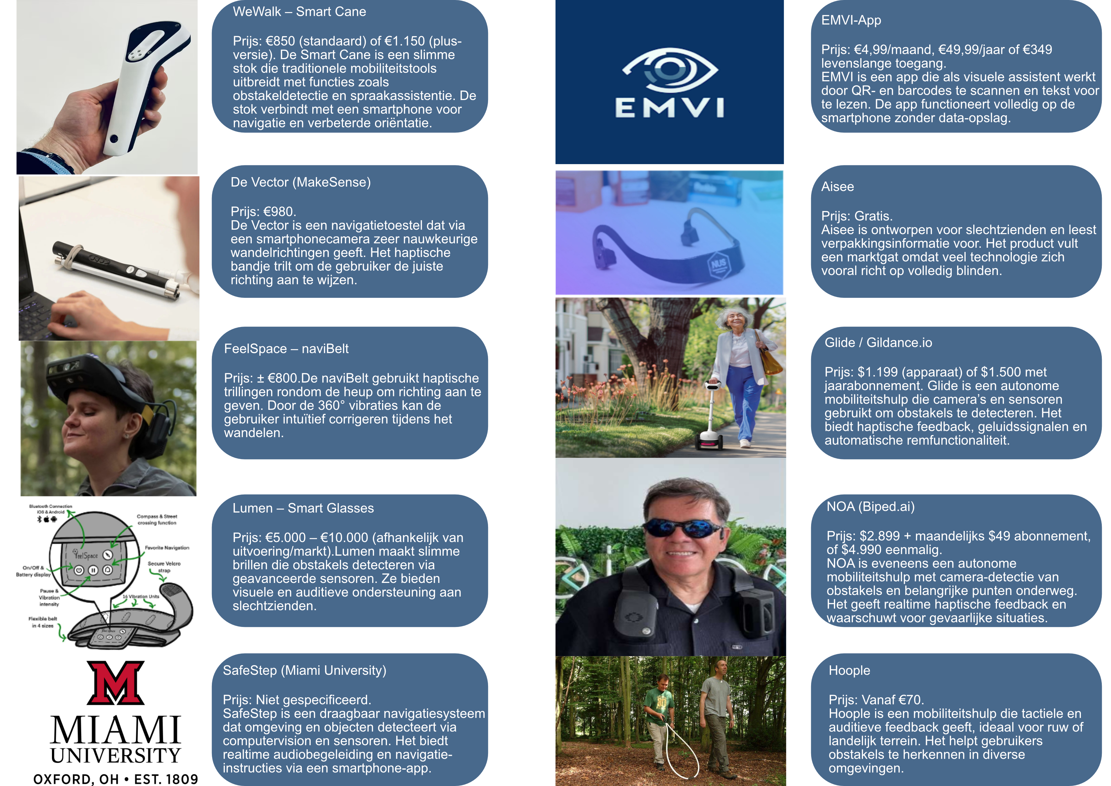
[picture p44: img/benchmarking.jpg]


>[!IMPORTANT] 
> Design Requirements:
> - D1.6 De interactie moet primair auditief en intuïtief zijn, zodat visuele input niet noodzakelijk is.
> - D1.9 Het product moet betaalbaar zijn voor thuisgebruik.

### Conclusies & implicaties fase 1
Op basis van interviews, enquête en benchmarking blijkt dat het grootste struikelblok voor blinden en slechtzienden het vinden en organiseren van producten is. Verplaatste items, onduidelijke labeling en inconsistentie zorgen voor frustratie en verlies van zelfstandigheid. Daarom richten we ons op de how might we: "Hoe maken we de koelkast toegankelijk voor blinden en slechtzienden?"

>[!IMPORTANT]
> Design Requirements:
> - D1.3 De oplossing moet samenwerking en communicatie tussen gebruiker, huisgenoten en zorgverleners bevorderen.

### Doestellingen fase 2
In de tweede fase vertrokken we uit de onderzoeksvraag: Hoe kunnen we de organisatie van een koelkast toegankelijk maken voor blinden en slechtzienden? Om deze vraag te beantwoorden zullen verschillende deelvragen beantwoord moeten worden.
### Materiaal & methoden fase 2
Om de onderzoeksvragen te beantwoorden werd opnieuw gebruik gemaakt van de methoden in fase 1:
1. Interviews (N=3)
2. Enquête (N=22)

### Resultaten fase 2
Welke hulpmiddelen en strategieën gebruiken zij vandaag al om hun koelkast georganiseerd te houden?

Blinden en slechtzienden organiseren hun koelkast heel goed. Ze plaatsen elk soort product op een specifieke plaats. Zo kunnen voorwerpen toch wat efficiënter gelokaliseerd worden in de koelkast. De houdbaarheidsdatum wordt door slechtzienden vaak groot op de verpakking geschreven, zo kunnen ze het makkelijker lezen. Blinden gebruiken momenteel veel AI detectiesoftware om producten te herkennen en de houdbaarheidsdata mee te krijgen.

Welke specifieke problemen of frustraties komen zij tegen bij het zoeken, herkennen en bereiken van producten in een koelkast?

Quote: “Ik moet vaak dingen weggooien omdat mijn partner vergeet te zeggen dat hij iets gekocht heeft.”

Quote: “Het is lastig om de datums op de verpakking te lezen. Daarvoor moet ik echt de vergrootfunctie van mijn iPad gebruiken. Meestal maak ik een foto, zoom ik er nog eens op in en schrijf ik de datum vervolgens met een dikke stift op de verpakking.”

Vaak treden er problemen omtrent communicatie op. Familieleden of begeleiders zetten niet altijd alles op de correcte plaats of ze zeggen niet wat is aangevuld of wat juist op is. Producten die bijna vervallen worden ook niet altijd opgemerkt, waardoor dingen vaak overdatum gaan of er schimmel kan ontstaan. Omdat er geen visuele cues zijn, moet de gebruiker elk product aftasten, wat tijdrovend en vermoeiend is.

Welke bestaande technologische hulpmiddelen kunnen helpen bij een toegankelijkere koelkast?

Herkenning van producten kan worden gedaan met AI herkenningsystemen zoals Be My Eyes. Producten kunnen ook worden geidentificeerd door het gebruik van NFC-tags, QR-codes of elektronische labels zoals PenFriend (audio-labelsystemen). Dit zijn handige manieren om snel belangrijke info te krijgen over het product dat je in je handen hebt.

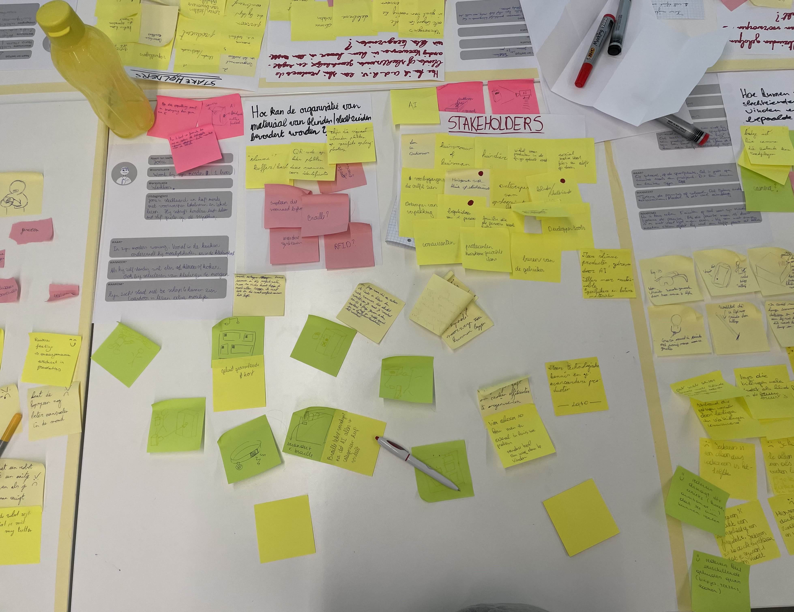
[picture p45: img/Sprintdag.jpg]


Welke niet-technologische hulpmiddelen worden er vooral gebruikt?

Vaste indelingsstructuren zoals eerder vermeld. Daarnaast worden tactile markers zoals rubberen noppen, elastiekjes of voelbare stickers vaak gebruikt. Ook eenvoudige hulpmiddelen zoals afspraken met huisgenoten dragen bij aan een vlotter gebruik van de koelkast.

> [!IMPORTANT] 
> Design Requirements:
> - D1.5 De oplossing moet het controleren van houdbaarheidsdata toegankelijk en betrouwbaar maken.
> - D1.6 (reeds onderbouwd in benchmarking, hier impliciet bevestigd)
> - D1.8 De oplossing moet functioneren als ondersteuning en mag de gebruiker niet afhankelijk maken van zorgverleners.

### Conclusies & implicaties fase 2
Belangrijke designbeslissingen voor een toekomstige oplossing:

- Het combineren van technologie en tastbare hulpmiddelen voor snelle herkenning van producten en houdbaarheidsdata.

- Het behouden van vaste indelingsstructuren om voorspelbaarheid en zelfstandigheid te bevorderen

- Het bevorderen van zelfstandigheid door duidelijke, toegankelijke feedback te bieden via audio, tast of vibratie.

- Het creëren van een oplossing die eenvoudig en intuïtief zijn zodat gebruikers deze perfect kunnen integreren in hun dagelijksleven.
