LeonDebonne/TasteMate/reports and protocols/Rapportering_interviews_develop1.docx

## Interviews Rapportering Develop1

### Project informatie

Projectnaam: TasteMate

In dit project onderzoeken we, in samenwerking met Licht & Liefde en de UGent-afdeling Orthopedagogiek en Disability Studies, hoe slimme producten kunnen bijdragen aan nieuwe ruimtelijke ervaringen voor mensen met een visuele beperking. Ons gekozen project is een slimme koelkastadd-on die het gebruiken van de koelkast vergemakkelijkt voor blinden en slechtzienden.

Interviewer: Leon Debonne (leon.debonne@ugent.be) en Staf Logie (staf.logie@ugent.be) , Studenten Industrieel Ingenieur Industrieel Ontwerpen

### Doelstelling en kadering

Het doel van deze interviews is extra conceptvalidatie. Zo kunnen we met extra zekerheid aan de materialisatie van het project beginnen. Ook kunnen deze interviews ons nog wat extra bevindingen opleveren die mogelijks tot goeie inzichten kunnen leiden voor ons project.

### Respondenten

De respondenten zijn blinde en slechtziende personen, evenals professionals die met hen werken, zoals begeleiders of ergotherapeuten. De blinde respondenten delen hun ervaringen vanuit het gebruikersperspectief, terwijl de professionals inzicht geven vanuit hun vakgebied in begeleiding en toegankelijkheid. Samen bieden ze een breedbeeld van de noden en mogelijkheden binnen de doelgroep.

### Rapportering

Welke hulpmiddelen gebruikt u of uw cliënt om de interactie met de koelkast te bevorderen?

Uit drie semigestructureerde interviews met begeleiders van blinde en slechtziende personen blijkt dat er momenteel vooral wordt teruggevallen op een combinatie van eenvoudige, praktische hulpmiddelen en menselijke ondersteuning om de interactie met de koelkast te bevorderen. Het geven van vaste plekken aan elke product in de frigo komt in elk interview terug. Dit is dus de basis waarop ze telkens terugvallen.

Verder wordt technologie in beperkte mate ingezet. Twee van de drie geïnterviewden geven aan dat een smartphone met spraakassistent (zoals VoiceOver of Zuzanka) gebruikt wordt om houdbaarheidsdata en beschrijving te laten voorlezen via scan-apps. Dit wordt echter als omslachtig ervaren, omdat verpakkingen eerst correct gepositioneerd moeten worden en houdbaarheidsdata niet altijd goed leesbaar of scanbaar zijn, zoals in situaties wanneer meerdere verpakking op of achter elkaar staan. In deze vervelende situatie moet er vaak teruggevallen worden op huisgenoten of hulpverleners

Deze interacties zijn telkens zeer tijdrovend. Daarom zou de TasteMate mogelijks een probleem voor deze doelgroep kunnen oplossen als we deze interacties veel vlotter laten gebeuren en dat niet telkens de gsm nodig is voor het zoeken van producten of houdbaarheidsdata.

Wat zijn hier de grootste struikelblokken?

De houdbaarheidsdata achterhalen is vooral het grootste struikelblok. De blinden en slechtzienden kunnen niet terugvallen op hun visuele oordeel van het product om zo de houdbaarheid na te gaan. Daarom moet dit zeker 1 van de hoofdzaken zijn waar we de meeste focus op zullen moeten leggen.

Het vinden van bepaalde product werd ook meerdere malen aangehaald, meestal worden misverstanden tussen huisgenoten als heel vervelend ervaren. Het geven van vaste plekken van elk soort voedsel in het TasteMate systeem zou een grote meerwaarde zijn. Dit doordat ook externen perfect zo de organisatie van de koelkast kunnen handhaven en zo het leven van hun huisgenoot een stuk makkelijker te maken. Zo kan de TasteMate ook telkens meegeven waar elk product zich zou moeten bevinden.

Feedback op TasteMate interface?

Op de interface kwamen enkele heel handige tips naarvoren. Het gebruiken van de app Zuzanka om de houdbaarheidsdata te herkennen zou voor ons systeem al een goede toevoeging zijn. Zo is niet telkens een onbetrouwbare schatting nodig voor sommige voedingswaren.

Ook werd genoemd dat het aanpassen of omwisselen van kleuren een grote meerwaarde zou kunnen leveren. Dit doordat slechtzienden vaak specifieke kleurcombinaties beter kunnen gaan waarnemen dan andere. Ook moet er op gelet worden dat de tekst altijd groot genoeg op het scherm komt te staan. Dit zijn kleine details die de gebruikservaring een hoop kunnen helpen bevorderen. Tot slot werd het ook heel belangrijk geacht de TasteMate beschikbaar te maken met schermleessoftware. Deze software zou het toelaten voor blinden om de interface ook te gaan gebruiken en niet enkel te moeten steunen op de AI-assistent.

Het idee om op de TasteMate slechts 1 knop te plaatsen enkel en alleen voor de assistent werd als terecht beschreven. Dit doordat dit ongewenst verwarring zou kunnen veroorzaken als ze op de verkeerde knop drukken. Elke andere functie zou ook via die assistent kunnen geraadpleegd worden, dus er is geen beperking qua functie.

Op de functie “kassabon scannen” kwam een goede opmerking. Namelijk dat in sommige winkels al via een klantenkaart de kassabon zou kunnen geraadpleegd worden. Dit zou kunnen zorgen voor een vlottere organisatie doordat het toevoegen van de producten dan eventueel automatisch zou kunnen gaan bij aankoop van deze producten.

Kan de TasteMate mogelijks nevenactiviteiten rondom te koelkast ondersteunen?

In de interviews werd genoemd dat er bij activiteiten zoals koken en winkelen zeker kleinere details kunnen zijn die de ervaring aangenamer maken voor de gebruikers. Hiervoor werd telkens als idee verwezen naar een mobiele applicatie. Voor het winkelen werd bv aangehaald dat een app die bijhoudt wat afwezig is in de koelkast zeer handig zou zijn. Zo kan via de schermleessoftware het online boodschappenlijstje geraadpleegd worden. Ook zou de begeleider via een app makkelijker kunnen ondersteunen bij de inventaris van de koelkast moest dit nodig zijn.

Het aanbieden van recepten die nog te maken zijn met de inhoud van de koelkast werd ook aangehaald. Dit wordt vaak onderschat doordat wij kunnen kijken in de koelkast wat er allemaal nog aanwezig is voor mogelijke gerechten. Dit zou het koken toch een beetje toegankelijker en vooral efficiënter gaan maken voor de doelgroep.
