LeonDebonne/TasteMate/reports and protocols/Protocol_User interviews develop1.docx

User interviews protocol

Projectinformatie

Projectnaam: TasteMate

Het doel van dit project is om het gebruik van de koelkast voor blinden en slechtzienden te bevorderen. Tegenwoordig zijn er weinig oplossingen die blinden en slechtzienden toelaat om de koelkast volledig autonoom te gebruiken. Zaken waarmee blinden en slechtzienden moeite mee hebben zijn het vinden van producten en ook de houdbaarheidsdatum aflezen.

Onderzoekers: Leon Debonne (leon.debonne@ugent.be) & Staf Logie (staf.logie@ugent.be (https://d.docs.live.net/fd7d235552eefb0e/Documents/Schooljaar%2025-26/Sem%201/Project%20gebruiksgericht%20ontwerpen/staf.logie@ugent.be)), Studenten industrieel ingenieur: industrieel ontwerpen, 2IO

Doel interviews tests

Bij deze gebruikerstesten/interviews is het de bedoeling om het concept te valideren en op zoek te gaan naar andere gaten die nog niet gecoverd zijn door ons product maar via enkele aanpassingen wel eenvoudig te integreren zijn. Hierbij spelen de interacties tussen de gebruiker en product een grote rol. Er wordt vooral gefocust op de begeleider omdat deze in principe meer met het product te werk gaat dan de visueel beperkte persoon. De blinde persoon maakt vooral gebruik van de AI-assistent, de rest van de functies worden gebruikt door de begeleiders of familieleden.

Methodes

Het interviews is semigestructureerd, dit laat ruimte vrij om spontane feedback te krijgen. Ook wordt het proces van het gebruik met de koelkast doorlopen om zo gaps te vinden in dit proces. Hierdoor wordt er ingezoomd op de interacties die plaatsvinden tijdens het gebruik.

Onderzoeksvragen

- Hoe wordt er momenteel gewerkt met de koelkast
- Wat zou helpen bij een vlottere werking?
- Waar zou ons systeem de grootste hulp bieden?
- Welke pijnpunten ziet u momenteel in dit product?
- Hoe voert een gebruiker bepaalde acties uit via ons ontwerp?

Respondenten

De respondenten zijn blinde en slechtziende personen, evenals professionals die met hen werken, zoals begeleiders of ergotherapeuten. De blinde respondenten delen hun ervaringen vanuit het gebruikersperspectief, terwijl de professionals inzicht geven vanuit hun vakgebied in begeleiding en toegankelijkheid. Samen bieden ze een breed beeld van de noden en mogelijkheden binnen de doelgroep

De interviews duren 40 minuten en worden afgenomen in de week van 2 maart.

Steekproefomschrijving (N = 2)

pseudonym | respondent type | interview datum | interview locatie
Jolien | Begeleider L&L | 4/03 | Online
Yoeri | Blinde | 2/03 | Online

Prototypes en materiaal

- Foto’s rendering
- Kartonnen prototypes
- Git
- FigmaMake Interface

Discussiegids

Deel 1: Inleiding en voorstelling geïnterviewde

Inleiding

Bedankt voor uw deelname aan dit onderzoek

We zullen starten met ons zelf eerst kort voor te stellen.

Wij zijn Leon Debonne en Staf Logie en we studeren aan de universiteit Gent campus Kortrijk met afstudeerrichting industrieel ingenieur industrieel ontwerpen.

Het project waar we momenteel mee bezig zijn heeft als doel het gebruik van de koelkast bevorderen voor blinde en slechtziende personen. Dit wordt gedaan door een add-on te ontwerp die aan de koelkast hangt. Deze kan gebruikt worden door de blinde of slechtziende persoon maar ook door de begeleider.

Uit het vooronderzoek bleek dat de visueel beperkte populatie moeite heeft met het gebruik van de koelkast. Dit vooral met het lokaliseren van de product en de houdbaarheidsdatum weten.

Vandaag willen we te weten komen of er nog zaken zijn die we over het hoofd zien en dat ons product nog kan oplossen. Dit zullen we doen via een interview en door eens het proces van het gebruik van de koelkast te doorlopen.

Als laatst willen we ook zeggen dat er geen juiste of foute antwoorden zijn. Het is belangrijke dat u uw oprechte mening en feedback geeft rond onze prototypes. Wees dus zeker niet bang om vragen te stellen of extra uitleg over het prototype. Als u ideeën heeft of dingen ziet die anders/beter kunnen zouden we dit zeer graag horen. We willen ook zeggen dat al uw feedback anoniem gebruikt zal worden in het verdere verloop van het project. Hiervoor hebben we een INFORMED CONSENT die u moet ondertekenen.

Voorstelling

Vooraleer we verdergaan met dit interview willen we wat meer zicht in de persoon die voor ons zit.

- Kunt u ons iets meer vertellen over jezelf?
  - Wat doe u in uw vrije tijd?
- Hoe zou u uw visuele beperking beschrijven?
- In welke mate gaat u zelfstandig door het leven?
- Wat is uw job en wat is de grootste uitdaging hieraan?

Deel 2: Hoofdvragen

Voordat we beginnen aan dit interview zullen we eerst nog extra duiding geven rondom het project. Het concept is dus een add-ons die aan de koelkast hangt.

FOTO RENDERING

Het bevat dus een scherm met een interfaces op die verschillende functies heeft. De hoofdfunctie is de AI-assistent die de blinde of slechtziende gebruiker begeleid doorheen het gebruik. Dit heeft dan vooral betrekking op de houdbaarheidsdatum en het aantal van een product. Het is dus de bedoeling dat gebruikers de inventaris bijhouden. Voor begeleiders en familieleden wordt dit gedaan via het scherm dat werkt via touchscreen. De visueel beperkte gebruikers doen dit dan met de AI-assistent via een conversatie. Deze assistent kan worden geraadpleegd via de tactiele knop bovenaan het apparaat. Bij het toevoegen van nieuwe items zijn we nog zoekend naar een oplossing maar daar ligt momenteel de focus niet op.

- Heeft u nog vragen rondom het concept?
- Hoe zou deze interface er volgens u kunnen uitzien?
- Hoe zou u een product toevoegen/ verwijderen?
- Hoe zou u een product opzoeken in de inventaris?
- Hoe zou u de gegevens van een product kunnen aanpassen?
- Hoe zou u de verdeling van de verschillende soorten voedsel in de koelkast aanpassen?
- Laat de respondenten mogelijks navigeren door de interface?

Deel 3: Proces gebruik v/d koelkast

Nu duiken we dieper in het gebruik van de koelkast zelf.

- Hoe gaat u dagelijks tewerk met de koelkast?
  - Gebruikt u al hulpmiddelen om deze interactie makkelijker te maken?
  - Heeft u last van producten die over datum gaan zonder dat u dit weet?
- Wat zijn hier de grootste struikelblokken?
  - Krijgt u hier ondersteuning mee van huisgenoten?
- Zijn er andere huisgenoten die de koelkast gebruiken? (Vlot verloop?)
  - Zetten huisgenoten/ begeleiders producten altijd op de juiste plaats?
- Hoe worden de boodschappen gedaan? Ziet u hier doen aan?
- Hoe gaat het bereiden van eten? Kookt u zelf?
  - Zou ons product daar mogelijks bij kunnen helpen?

Deel 4: Evaluatie en acceptatie

Evaluatie

- In het algemeen, wat vindt u van dit idee?
- Wat vindt u er goed aan?
- Wat vindt u er eventueel minder goed aan?
- Wat zou u zelf aanpassen mocht u kunnen kiezen?
  - Zijn er ander problemen die zouden kunnen worden opgelost met het product?
  - Zijn er interacties tussen de visueel beperkte persoon en de koelkast of de begeleider/familielid die over het hoofd worden gezien?

Acceptatie

Ten slotte willen we nog weten of dat u dit product zou gebruiken.

- Zou u dit product gebruiken?
  - In welke context?
  - Wanneer?
  - Wat zijn de mogelijke barrières? Waarom zou u het misschien niet gebruiken?
- Wat zijn de grootste redenen voor dit antwoord?
  - Hoe kan dit antwoord veranderd worden?

Achteraf

Deelnemer bedanken en vragen om wat foto’s te nemen met de producten.
