LeonDebonne/TasteMate/reports and protocols/Enquête protocol.docx

Enquête protocol

Projectinformatie

Projectnaam: Spatial Experiences for Visually Impaired populations

Het doel van dit project is om mensen met een visuele beperking te helpen met een product waarmee hun ruimtelijke ervaring kan bevorderd worden.

Blinden en slechtzienden komen dagelijks in contact met hordes doordat de samenleving niet is afgesteld op hun noden. Door deze problemen aan te pakken kunnen we de wereld meer toegankelijk maken voor alle mensen.

Onderzoeker: Leon Debonne (leon.debonne@ugent.be), Student industrieel ingenieur: industrieel ontwerpen, 2IO

Doel enquête

De enquête wordt in de eerste plaats afgenomen met het oog op geëngageerde mensen contacteren in Facebookgroepen die mogelijks bereid waren om interviews te doen. Dit is ook een goede opportuniteit om algemene vragen te stellen aan de community.

Door deze algemene vragen kan al eens gepolst worden naar wat mensen nodig hebben en welke dagelijkse hordes er moeten overkomen worden door blinden en slechtzienden.

De volgende stap is nog wat dieper gaan op de 1 op 1 interviews om echt gerichte vragen te stellen. De interviewvragen worden opgesteld op basis van de antwoorden van de enquête.

Onderzoeksvragen

- Waar hechten blinden en slechtzienden belang aan?
- Welke hordes moeten er dagelijks overkomen worden?
- Wat is de visie t.o.v. de opkomende technologieën/ hulpmiddelen?
- Welke rol speelt een begeleider of familielid in hun leven?
- Hoe gebeurt de organisatie binnenshuis?
