LeonDebonne/TasteMate/reports and protocols/Interview Protocol.docx

## Interview protocol

### Project informatie

Projectnaam: Spatial Experiences for Visually Impaired populations

In dit project onderzoeken we, in samenwerking met Licht & Liefde en de UGent-afdeling Orthopedagogiek en Disability Studies, hoe slimme producten kunnen bijdragen aan nieuwe ruimtelijke ervaringen voor mensen met een visuele beperking.

Interviewer: Leon Debonne (leon.debonne@ugent.be), Student Industrieel Ingenieur Industrieel Ontwerpen

### Doelstelling en kadering

De problematiek ligt bij de beperkte ruimtelijke oriëntatie en beleving van blinden en slechtzienden. De interviews hebben als doel hun ervaringen, noden en uitdagingen beter te begrijpen om een passend ontwerp te ontwikkelen. Ze maken deel uit van de onderzoeksfase van het ontwerpproces.

### Respondenten

De respondenten zijn blinde en slechtziende personen, evenals professionals die met hen werken, zoals begeleiders of ergotherapeuten. De blinde respondenten delen hun ervaringen vanuit het gebruikersperspectief, terwijl de professionals inzicht geven vanuit hun vakgebied in begeleiding en toegankelijkheid. Samen bieden ze een breedbeeld van de noden en mogelijkheden binnen de doelgroep

De interviews duren 20 minuten en worden afgenomen van 15-27/oktober

Steekproefomschrijving (N = 3)

pseudonym | respondent type | interview datum | interview locatie
Natascha | Begeleider | 27/10 | Kortrijk
Yoeri | Blinde | 21/10 | Online
Ignance | Blinde | 21/10 | Online

Piet devos

# Onderzoeksvragen

How can smart products create meaningful new spatial experiences for visually impaired populations?

# Overzicht van de discussiegids en tijdsinschatting

- Deel 1 – Introductie (5’)
- Deel 2 – Voorstelling Interviewee (5’)
- Deel 3 – thema 1(10’)
- Deel 4 – thema 2 (5’)
- Deel 5 – Wrap-up (2’)

# Discussiegids

## Introductie 5’

Bedankt voor je deelname aan dit onderzoek.

Ik zal starten met het project en mezelf kort voor te stellen.

Ik ben Leon Debonne en ik studeer aan de universiteit Gent campus Kortrijk met afstudeerrichting industrieel ingenieur industrieel ontwerpen.

Dit interview wordt uitgevoerd in het kader van het vak Project Gebruiksgericht Ontwerp, waarin de nadruk ligt op het ontwerpen van producten die vertrekken vanuit de noden en ervaringen van de gebruiker. De uitdaging binnen dit project is het ontwikkelen van een product dat de ruimtelijke ervaring van blinden en slechtzienden verbetert, zodat zij zich zelfstandiger en zekerder kunnen bewegen in hun omgeving.

Met dit interview wil ik inzicht krijgen in de dagelijkse ervaringen, moeilijkheden en behoeften van blinden en de mensen die met hen werken. De deelname van de respondent is belangrijk, omdat hun persoonlijke ervaring en expertise essentieel zijn om tot een ontwerp te komen dat echt aansluit bij de doelgroep.

Tijdens het interview zal ik vragen stellen over hoe blinden hun omgeving ervaren, welke hulpmiddelen zij momenteel gebruiken, en waar volgens hen nog verbetering mogelijk is. Ook wordt besproken welke situaties zij als moeilijk of juist goed opgelost ervaren.

De inzichten van de respondent zijn waardevol omdat zij helpen om het ontwerpproces te sturen op basis van echte gebruikerservaringen, in plaats van aannames. Hun input vormt een directe inspiratiebron voor het ontwikkelen van een product dat niet alleen functioneel, maar ook betekenisvol is voor de gebruiker.

Ik ben erg benieuwd naar jouw inzichten en ervaringen. Er zijn geen juiste of foute antwoorden. Ik ben gebaat bij jouw oprechte feedback rond de topics die we zullen behandelen.

Ik wil zeker nog onderstrepen dat alles wat straks in het gesprek aan bod komt in absolute confidentialiteit behandeld wordt. We zijn als studenten aan de Ugent namelijk gebonden aan de Europese privacy richtlijnen. Voor de synthese met de inzichten en aanbevelingen worden individuele meningen sowieso ook geanonimiseerd. Je naam zal met andere woorden niet gekoppeld worden aan specifieke uitspraken. Een meer gedetailleerde beschrijving van onze intenties, verwerking van gegevens, en algemeen beleid kan je nalezen in de ‘Informed Concent’. Voor we van start kunnen met het interview, heb ik jouw expliciet akkoord nodig met dit document.

Ten slotte, had ik je ook graag gevraagd of ik straks dit gesprek mag opnemen met een voice recorder, om ons gesprek te kunnen herbeluisteren wanneer de analyse wordt gemaakt. Uiteraard wordt deze opname niet gedeeld met derden, en verwijderd na afloop van het project. Als u hiermee akkoord gaat, stel ik voordat we het interview beginnen.

## ----------------------------[invullen informed consent & start recording] ----------------------------

## Contextuele vragen

## Voorstelling Interviewee 5’

Alvorens we in de materie duiken, wil ik graag eerst even kennismaken.

- Kan je kort jezelf voorstellen?
  - Wat doet u in je vrije tijd?
  - Zou u uw visuele beperking kunnen beschrijven?
  - Heeft u kinder of echtgenoot?
- Kan je me iets meer over je job vertellen?
  - Hoe zou je je functie omschrijven? En wat houdt je job precies in?
  - Waar ligt voor jou persoonlijk de grootste uitdaging?
  - Kan je mij eens meenemen in een doorsnee dag op werk?
  - Ondervindt u moeilijkheden op het werk of gerelateerd aan werk?

## Hoofd vragen 10’

- Welke hulpmiddelen bent u momenteel het meest tevreden mee?
- Welke hulpmiddelen vindt u minder?
- Welke hebben wel veel potentieël volgens u?

Sensotec → Brugge

Cobravision

- Welke activiteiten heeft u het meest moeite mee?
- Zijn er activiteiten die u juist perfect kan, maar veel mensen denken van niet?
- Vindt u het vervelend dat mensen aan uw hulpmiddelen kunnen zien dat u een visuele beperking heeft?
- Wat is de beste manier om informatie over te brengen aan mensen met een visuele beperking? - Enige ervaring met een brailleregel?
- Is info horen wel handig als het over opsommingen gaat? Bv bestellen op een webshop? Hoe gebeurt dit dan meestal?
- Zijn er activiteiten die u altijd onder begeleiding uitvoert?
- Zo ja, Welke?
- Enige ervaring met een geleide hond?
- Vanaf 18 jaar pas.

Kim Bols website

Topic 1 Binnenshuis 5’

- Heeft u al problemen ondervonden met het samenleven met iemand die niet slechtziend is? - Ontstaan er vaak misverstanden? - Verplaatst die persoon spullen die u vervolgens moet zoeken? - Idee aankaarten rond smart fridge.
- Zijn er huishoudelijke taken die niet te doen zijn?

-Zijn er die wel zouden kunnen lukken met de nodige aanpassingen aan het product?

- Heeft u problemen met het lokaliseren van producten binnenshuis?

-Enige ervaring met spraaklabels of NFC-tags

- Ondervindt u problemen met het feit dat u geen gezichtsexpressies kan waarnemen?

Wrap-up 2’

Wenst u zelf nog zaken toe te voegen, waar ik misschien geen aandacht voor had? ..

Drollen oprapen heel irritant.

Heeft u nog een tip voor mij doorheen dit project? …

De belangrijkste zaken die ik heb geleerd uit dit interview zijn, …

Heb ik het juist begrepen als …?

Wat zijn de belangrijkste elementen waarvan u denkt die belangrijk zullen zijn rekening mee te houden tijdens het ontwerpen van dit product?...

Heeft u zelf misschien enkele ideeën voor een slim product die u het leven makkelijker zou kunnen maken? …
