LeonDebonne/TasteMate/reports and protocols/Interviews Rapportering.docx

Interviews Rapportering

Welke hulpmiddelen bent u momenteel het meest tevreden mee?

De geïnterviewden zijn in het algemeen heel positief over de witte stok, aangezien deze heel veel vrijheid biedt. De witte stok is echter niet perfect. Hij kan je niet alles laten weten, het voelt gewoon of het pad voor u vrij is. Daarnaast is spraaksoftware zoals VoiceOver of JAWS heel populair. Heel veel gebruiken deze hulpmiddelen.

Ook verglootglazen, elektronische loepen en apps zoals Be My Eyes zijn vaak genoemd als onmisbare hulpmiddelen om zelfstandig door het leven te kunnen gaan.

Spraaklabels werden ook genoemd. Dit is een zeer interessant product om zo voorwerpen te kunnen identificeren. De spraaklabels zijn wel niet perfect, ze kunnen bijvoorbeeld niet tegen water.

Welke activiteiten heeft u het meest moeite mee?

Vaak werd genoemd dat navigeren in openbare gebouwen zeer lastig is. Het vinden van toiletten of bepaalde producten in de winkel is telkens een struikelblok voor blinden en slechtzienden.

Veel taken zijn ook een leerproces werd er verteld. Na veel trail en error komen er voor verschillende taken vaak toch manieren op om deze toch zelfstandig te gaan uitvoeren. Dit kost vaak wel veel energie om elke taak op een alternatieve manier uit te voeren.

Ook werd opgebracht dat ze vaak te maken hebben met mensen die willen helpen, maar dat ze de taak perfect zelf kunnen. Ze appreciëren het, maar ze willen niet gezien worden als hopeloos. Ze kunnen vaak meer taken dan dat ziende mensen zouden denken.

Vindt u het vervelend dat mensen aan uw hulpmiddelen kunnen zien dat u een visuele beperking heeft?

Bij de oudere mensen blijkt dit geen probleem meer te zijn. Al vertelden ze dat dit in hun jongere jaren wel echt moeilijk was voor hen. Omdat ze niet graag als abnormaal gezien wilden worden. Echter na een paar jaar is dit geen probleem meer. Er werd wel aangehaald dat ze niet als een “cyborg” over straat willen lopen. Daarmee bedoelen ze dat ze niet voor elk klein probleem een hulpmiddel moet zijn, maar meer geïntegreerde systemen, zodat ze niet met 100 hulpmiddelen moeten rondlopen. Ook werd op prijs gesteld dat hulpmiddelen mooi en niet te oubollig waren.

Wat is de beste manier om informatie over te brengen aan mensen met een visuele beperking?

Voor grote tekst werd braille als heel nuttig aangehaald, door dat dit veel minder tijd in beslag neemt. Voor andere soorten informatie is spraak meestal de beste optie. Bij het lezen van menukaarten bijvoorbeeld wordt vaak de kaart gescand en dit wordt dan voorgelezen. Ook kunnen er vragen gesteld worden bv. zijn er gerechten zonder vlees?

Als het om knoppen gaat zijn voelbare knoppen zeer interessant doordat dit heel snel de info overbrengt.

Zijn er activiteiten die u altijd onder begeleiding uitvoert?

Veel geïnterviewden geven aan dat ze bepaalde activiteiten altijd met begeleiding doen, zoals reizen naar onbekende plekken, boodschappen doen in drukke winkels, of bezoeken aan nieuwe locaties. Activiteiten binnenshuis doen de meesten zelfstandig, tenzij er sprake is van volledige blindheid.

Heeft u al problemen ondervonden met het samenleven met iemand die niet slechtziend is?

Er werd aangehaald dat er soms zonder na te denken spullen verplaatst worden door huisgenoten waardoor de blinde die spullen niet meer terugvind. Veel van deze problemen komen tot stand door communicatieproblemen. Ook werd het probleem aangehaald dat er voedsel slecht word doordat de ziende dit in de frigo steekt, maar dit niet communiceert. De organisatie in de frigo is ook een moeilijk punt. De blinden haalden aan dat ze altijd zelf alles in de frigo willen steken, zodat ze weten waar alles ligt.

Ook is het zeer gevaarlijk als er obstakels in huis gezet worden waar de blinde niet vanaf weet. Hier zijn al enkele ongelukken mee gebeurd.

Heeft u problemen met het lokaliseren van producten binnenshuis?

De meesten geven aan dat ze weinig problemen hebben zolang alles een vaste plek heeft. Wanneer iemand iets verplaatst, kan dat echter voor grote verwarring en frustratie zorgen. Goede organisatie en consistentie worden als essentieel genoemd.

Keyfinders worden ook vaak gebruikt. Zo kan er een geluidje afgespeeld worden en kan de blinde vervolgens het object wel terugvinden.

Voor het selecteren van kleren wordt een kleurscanner gebruikt. Deze wordt op het kleer gedaan en verteld vervolgens welke kleur het is. Zo kunnen mensen toch zelf hun kleren uitkiezen.

Ondervindt u problemen met het feit dat u geen gezichtsexpressies kan waarnemen?

Dit is blijkbaar enkel een probleem bij mensen die ze niet zo goed kennen. Blijkbaar kunnen ze aan de toon horen hoe mensen hun uitdrukking is.
