LeonDebonne/TasteMate/img/CMF-types.png

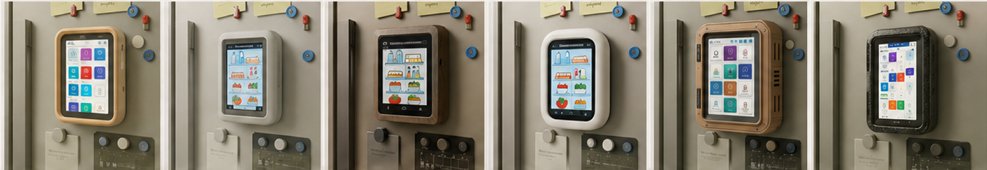
img/CMF-types.png
