LeonDebonne/TasteMate/img/Exploded.png

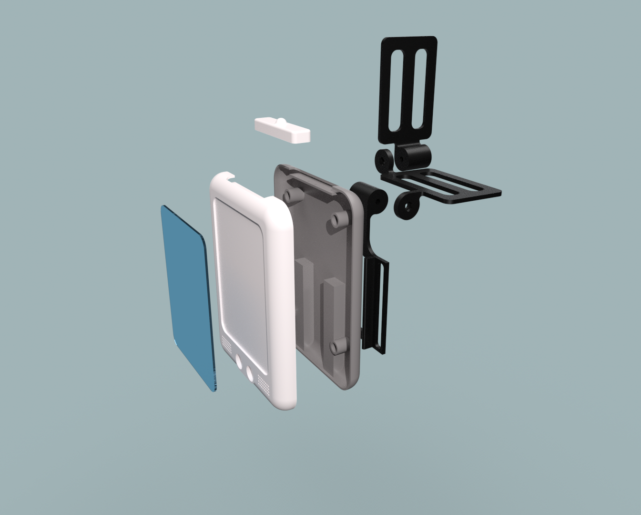
img/Exploded.png
