LeonDebonne/TasteMate/img/Group 2.png

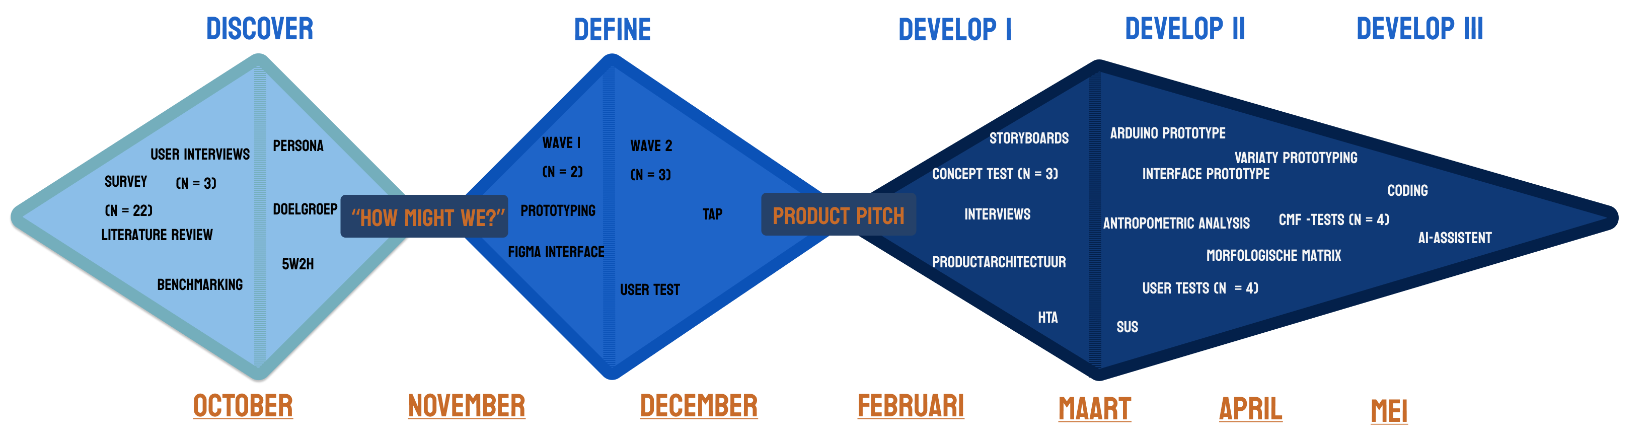
img/Group 2.png
