LeonDebonne/TasteMate/img/Proto1.JPEG

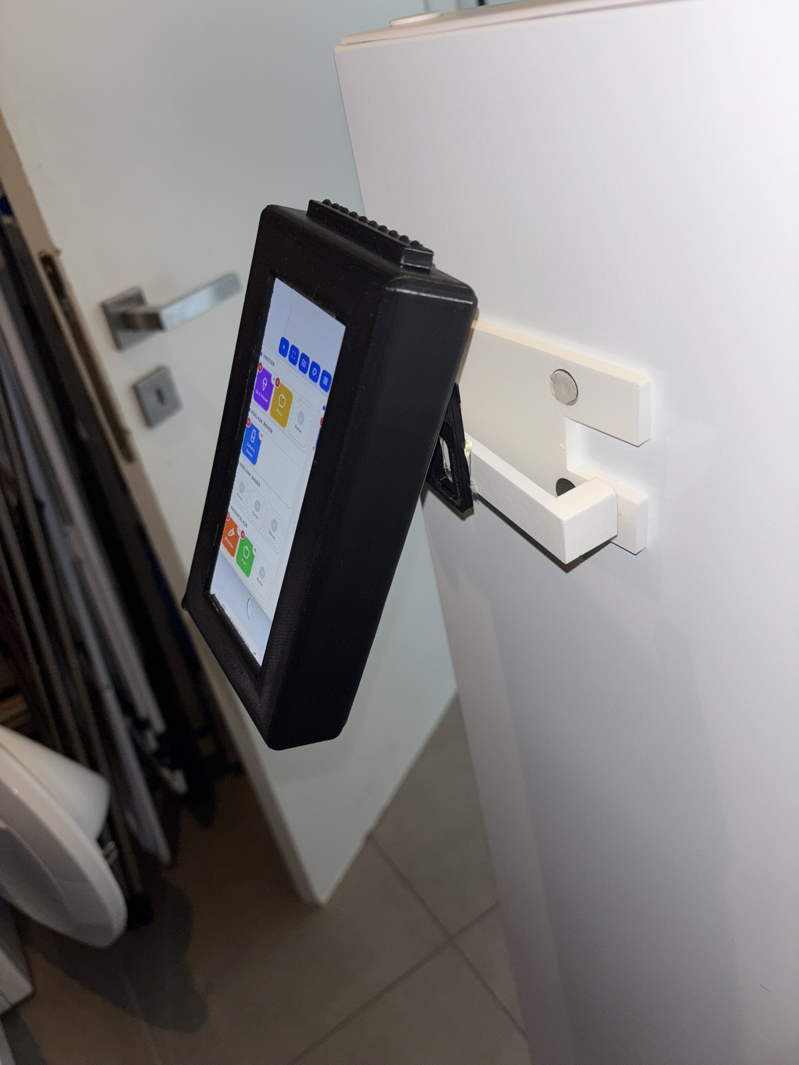
img/Proto1.JPEG
