LeonDebonne/TasteMate/img/Render_Vizcom.png

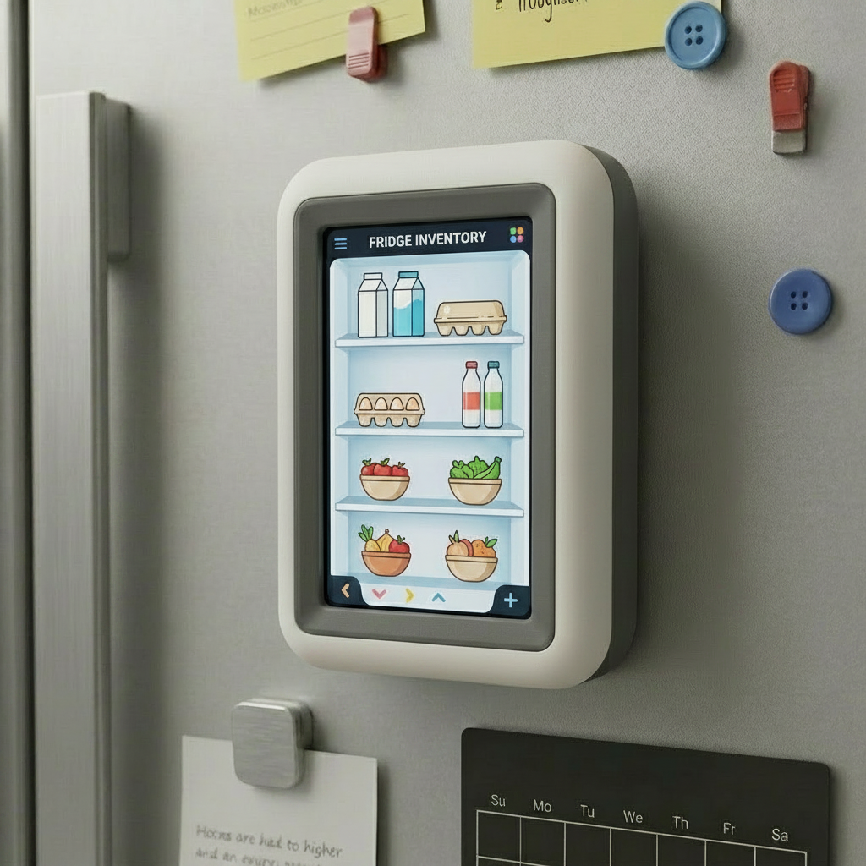
img/Render_Vizcom.png
