LeonDebonne/TasteMate/img/TasteMate Render3.png

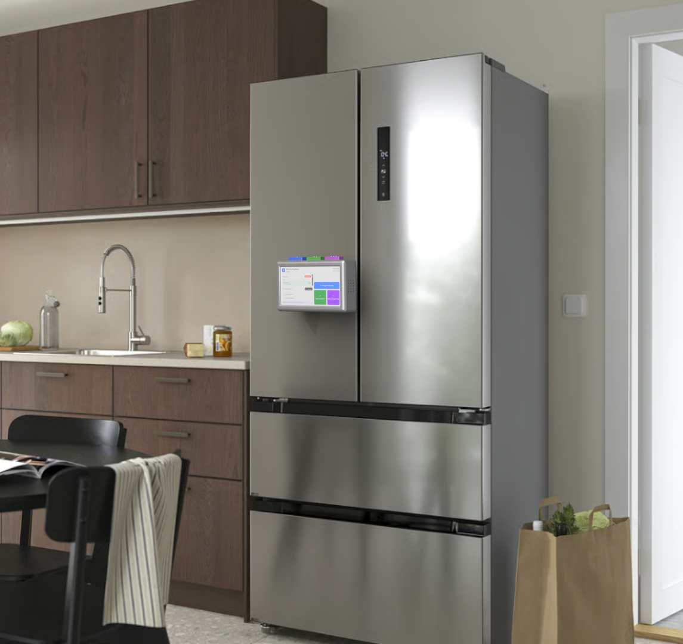
img/TasteMate Render3.png
