LeonDebonne/TasteMate/docs/bom.md

## Bill of materials deelopdrachten

### Defenition:

- Karton
- Plakband
- Kleurpotloden

### Develop 1:

- [PLA](https://acproducts.nl/products/creality-pla-filament-hyper-speed-zwart-1-75-mm-1-kg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)
- Zand
- Magneten
- Dubbelzijdige tape
- Pritt kleefgum
- Plastic zak
- Plakband

### Develop 2:

- [PLA](https://acproducts.nl/products/creality-pla-filament-hyper-speed-zwart-1-75-mm-1-kg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)
- Lintmeter
- Werkende GSM
- Magneten
- Lijm + lijmpistool

### Develop 3:

- [PLA](https://acproducts.nl/products/creality-pla-filament-hyper-speed-zwart-1-75-mm-1-kg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)
- Multiplex
- Sheetmetal

## Finaal product

### Bill of materials

| Onderdeel | Aantal | Prijs | Bron |
|:---:|:---:|:---:|:---:|
|[Raspberry PI 2](https://www.reichelt.com/be/nl/shop/product/raspberry_pi_b_4x_usb_2_0_40_pin_gpio-146194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)| 1 | €27 | Reichelt |
|[Touchscreen Display 4.3 inch](https://www.kiwi-electronics.com/nl/4-3inch-hdmi-lcd-b-800x480-ips-capacitive-touch-4065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) | 1 | €60 | Kiwi |
| [Speaker](https://www.amazon.com.be/-/nl/GERUI-mini-luidsprekers-pin-interface-doe-het-zelfprojecten-lcd-tv-monitoren/dp/B0F32MQNXH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) | 1 | €7 | Amazon |
| [PnP Microfoon](https://www.amazon.com/MillSO-Microphone-Omnidirectional-Recording-Podcasting/dp/B0CJHTVQ54?th=1) | 1 | €12 | Amazon |
| [Afstandssensor HC-SR04](https://benl.rs-online.com/web/p/bbc-micro-bit-add-ons/2153181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) | 1 | €3| RS |
| [Buzzer](https://benl.rs-online.com/web/p/piezo-buzzers/0238038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) | 2  | €4 | RS |
| [MAX98357A I2S Amplifier](https://www.amazon.com.be/-/nl/MAX98357A-Amplifier-Breakout-DAC-decoder-toepassingsgebied/dp/B0F21T7Q3P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) | 1 | €3 | Amazon |
| [Button](https://benl.rs-online.com/web/p/tactile-switches/2693801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) | 1 | €0,5 | RS |
| [Jumpers](https://www.kiwi-electronics.com/nl/premium-jumperwires-op-strip-40-stuks-f-f-20cm-590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) | 15 | €3 | Kiwi |
| [HDMI kabel](https://www.amazon.com.be/-/nl/Equip-119310-Speed-HDMI-kabel-Ethernet/dp/B09977HWCM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) | 1  | €8,6 | Amazon |
| [USB - Micro-USB kabel](https://www.amazon.com.be/-/nl/Hama-Micro-USB-kabel-snellaadkabel-PS4-controller-Android-apparaten/dp/B0BL19L7NK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) | 3 | €5 | Amazon |
| [USB wifi adapter](amazon.com.be/-/nl/TP-Link-WiFi-dongle-wifi-adapter-wifi-dongle-T2U/dp/B07KRCW6LZ/ref=asc_df_B07KRCW6LZ?mcid=852928d45dda3abfa57e9e1627f34a65&tag=begogshpadd0d-21&linkCode=df0&hvadid=714453674833&hvpos=&hvnetw=g&hvrand=8046058247111062234&hvpone=&hvptwo=&hvqmt=&hvdev=c&hvdvcmdl=&hvlocint=&hvlocphy=9197127&hvtargid=pla-640626983653&psc=1&language=nl_BE&gad_source=1) | 1 | €12 | Amazon |
| [Generic PLA](https://eu.store.bambulab.com/nl/products/pla-basic-filament) | 2 | €11,5 | Bambu |
| [1,5mm PMMA](https://www.amazon.com.be/Signal%C3%A9tique-biz-France-Transparante-acrylplaat-ge%C3%ABxtrudeerd/dp/B0BFHNWQ7F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) | 1 | €8 | Amazon |
| [M5 bout](https://www.toolstation.be/metaalschroeven-bolkop/p25348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) | 2 | €2,7 | Toolstation |
| [M5 borgmoer](https://www.toolstation.be/borgmoeren/p12051) | 2 | €3 | Toolstation |
| [Dubbelzijdige tape](https://www.123inkt.be/123inkt-dubbelzijdige-nano-tape-20-mm-x-3-m-i95484.html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)| 1 | €4 | Inkt123 |

### Building instructions
#### Elektonica
Het volledig systeem dient als volgt geschakeld te worden:

<p align="center">
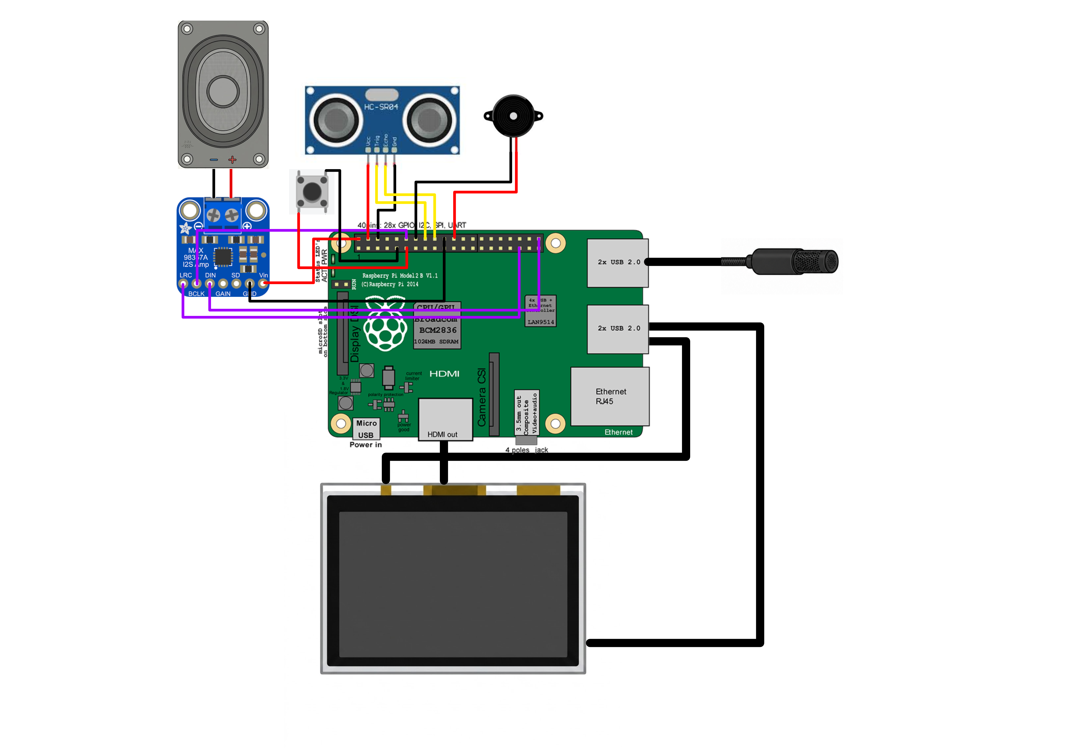
[picture p54: img/SchemaRPi.png]
  
</p>

Er wordt gebruikt gemaakt van een Raspberry Pi 2 met onderstaande layout qua GPIO-pinnen.

<p align="center">
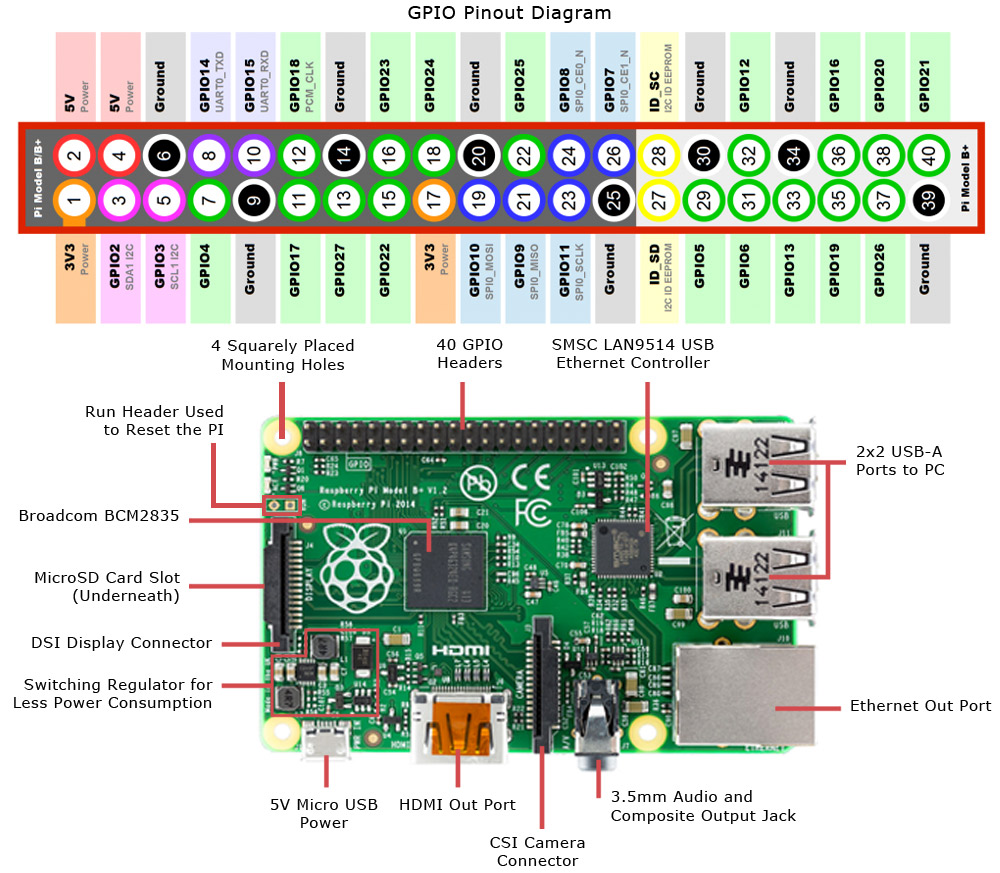
[picture p55: img/Layout_Rpi.jpg]
  
</p>

1. Om te beginnen dient er een micro-sd-kaartje met de Raspberry Pi Imager in het toestel gestoken te worden om deze te booten. 

2. Hierna dient de wifi geconfigureerd te worden via de wifi adapter.

3. Vervolgens moeten de mappen assistent, wake_up en webserver op het toestel gezet worden samen met het startbestand. Dit wordt gedaan door deze GIT te clonen.

4. Daarna moeten de system dependencies geinstalleerd te wordenen, dit bevat Python en andere hardware en wordt gedaan met de commando's: 
    ```
    sudo apt update && sudo apt upgrade -y
    sudo apt install python3 python3-pip python3-venv git
    sudo apt install python3-gpiozero
    sudo apt install nodejs npm
    ```
    en
    ```
    cd webserver
    npm install
    ```
5. Vervolgens dient een virtual environment gestart te wordenom conflicten in tussen de codes te vermijden.
    ```
    python3 -m venv venv
    source venv/bin/activate
    ```
6. Hierna moeten de nodige libraries geinstalleerd worden in deze venv.
    Voor het wake up bestand is dit
    ```
    pip install pyautogui
    ````
    en voor de assistent is dit
    ```
    pip install speechrecognition 
    pip install google-genai 
    pip install edge-tts 
    pip install pygame
    pip install pyaudio
    pip install 
    ```

    voor de servers is dit
    ```
    pip install flask flask-cors
    ```
7. Daarna moet de server gebuild worden.
    ```
    cd webserver
    npm run build
    ```
8. Als laatste dient er ingesteld te worden dat het [startbestand](/src/start_tastemate.sh) automatisch opstart.
    Eerst moet het bestand uitvoerbaar gemaakt worden met:
    ```
    chmod +x /home/tastemate/start_tastemate.sh
    ```
    en dan moet het worden ingesteld via de terminal met:
    ```
    nano /home/tastemate/.config/lxsession/LXDE-pi/autostart
    ```
    in dit bestand moet er dan gezet worden
    ```
    @/home/tastemate/start_tastemate.sh
    ```

#### Mock-up
Doordat we niet beschikten over de juiste hardware om het product uit te werken tot een stand-alone object, is er een mock-up gemaakt om een idee te geven van hoe het product eruit zou zien.

De CAD-bestanden voor de behuizing en de tactiele knop bevinden zich in deze map. Deze onderdelen dienen ge-3D-print te worden, net als het CAD-bestand van het scharnier. Het scharnier wordt vervolgens correct bevestigd met behulp van M5-bouten en borgmoeren. De behuizing kan daarna over de T-structuur van het scharnier schuiven.

Om het scherm te simuleren wordt er gebruikgemaakt van een afgedrukt interface met een stuk plexiglas erboven. De sensor wordt op een gelijkaardige manier vervaardigd: twee cirkels plexiglas worden over de cilindrische delen van de afstandssensor geplaatst. De juiste vorm van de plexiglasonderdelen wordt bekomen door het [Lightburn-bestand](/cad/Plexi.lbrn) uit te voeren. Alle onderdelen worden bevestigd met lijm.

Tot slot is er de knop. Een Arduino-drukknop wordt bovenaan vastgelijmd met de pinnen in de voorziene gaten. Het tactiele element van de knop past vervolgens over de Arduino-drukknop.

Het geheel wordt aan de koelkast bevestigd via dubbelzijdige tape aan het scharnier.
