LeonDebonne/TasteMate/(list of files, cad)

Other CAD files:
cad/Behuizing_TasteMate.prt
cad/Scharnier.prt
cad/Tactiele_Knoppen.prt
cad/TasteMate assy.prt
cad/TasteMate.prt
cad/Vormen.prt
