LeonDebonne/TasteMate/reports and protocols/Concept test protocol.docx

Concept test protocol

Projectinformatie

Projectnaam: TasteMate

Het doel van dit project is om het gebruik van de koelkast voor blinden en slechtzienden te bevorderen. Tegenwoordig zijn er weinig oplossingen die blinden en slechtzienden toelaat om de koelkast volledig autonoom te gebruiken. Zaken waarmee blinden en slechtzienden moeite mee hebben zijn het vinden van producten en ook de houdbaarheidsdatum aflezen.

Onderzoekers: Leon Debonne (leon.debonne@ugent.be) & Staf Logie (staf.logie@ugent.be (https://d.docs.live.net/fd7d235552eefb0e/Documents/Schooljaar%2025-26/Sem%201/Project%20gebruiksgericht%20ontwerpen/staf.logie@ugent.be)), Studenten industrieel ingenieur: industrieel ontwerpen, 2IO

Doel concept test

Het doel van deze concept test is het valideren van de bevestigingsmethode van de TasteMate aan de koelkast.

Methodes

Er worden 3 verschillende bevestigingsmethoden onderzocht. Deze bevatten: magneten, dubbelzijdige tape en kleefgum. Om dit te testen wordt er een scharnier gemaakt waar er een gewicht wordt aangehangen. Het gewicht van het uiteindelijke prototype wordt geschat rond de 500g. Door het scharnier dan open en toe te klappen kan er worden geobserveerd welke bevestigingsmethode het beste werkt.

Onderzoeksvragen

- Hoe wordt het product aan de koelkast bevestigd?

Prototypes en materiaal

- Prototype scharnier
- Magneten
- Dubbelzijdige tape
- Kleefgum
- Plastic zak
- 500g zand
