LeonDebonne/TasteMate/reports and protocols/Concept test rapport.docx

Concept test rapport

Doelstellingen

- Onderzoeken welke bevestigingsmethode werkt voor ons product.
- Extra conceptvalidatie

Materiaal & methoden

- Verbindingen

Hier werden 3 verschillende soorten verbindingen getest.

- Magneten
- Dubbelzijdige tape
- Kleefgum (Pritt Buddies)

Methodiek

Voor het testen van de verschillende verbindingen wordt gebruik gemaakt van een gewicht van 500g. Dit gewicht zorgt voor een simulatie van het product dat aan de scharnieren zal moeten bevestigt worden.

De scharnier wordt bij elke verbinding getest bij gesloten stand en open stand. Zo kan zowel de sterkte van de scharnier getest worden alsook de sterkte van de verbinding.

Resultaten

- Magneten

Bij het verbinden via magneten bleef het scharnier mooi hangen bij gesloten stand. Echter werd bij het openen van het scharnier duidelijk dat het moment van de massa te groot was en het scharnier langzaam scheef begon te hangen. Dit zou kunnen opgelost worden door nog sterkere magneten te gaan gebruiken, maar dit zou snel de prijs omhoog gaan jagen. Ook zijn magneten enkel mogelijk bij koelkasten die niet ingebouwd zijn.

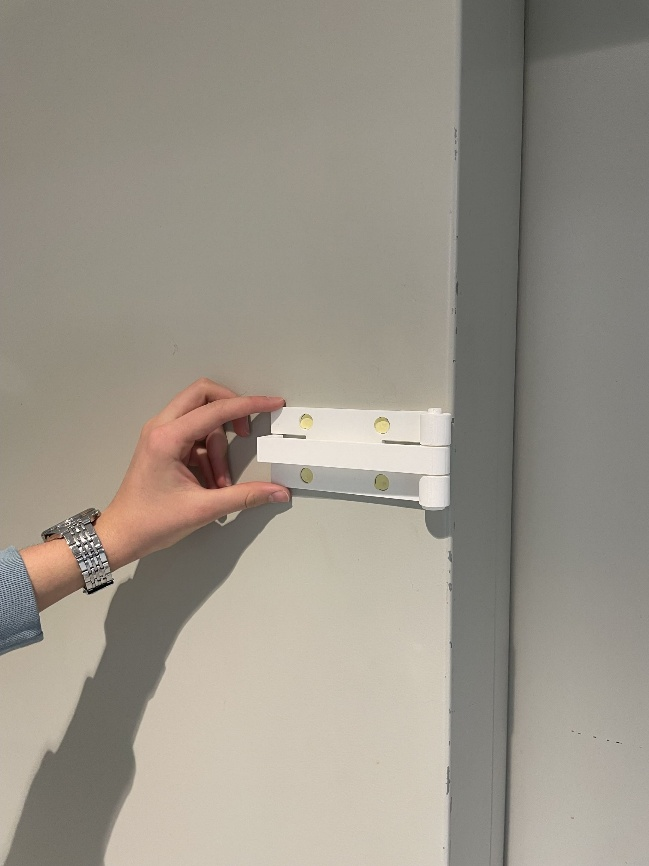
[picture p71: figure]
Afbeelding met persoon, tekst, muur, vinger Door AI gegenereerde inhoud is mogelijk onjuist.
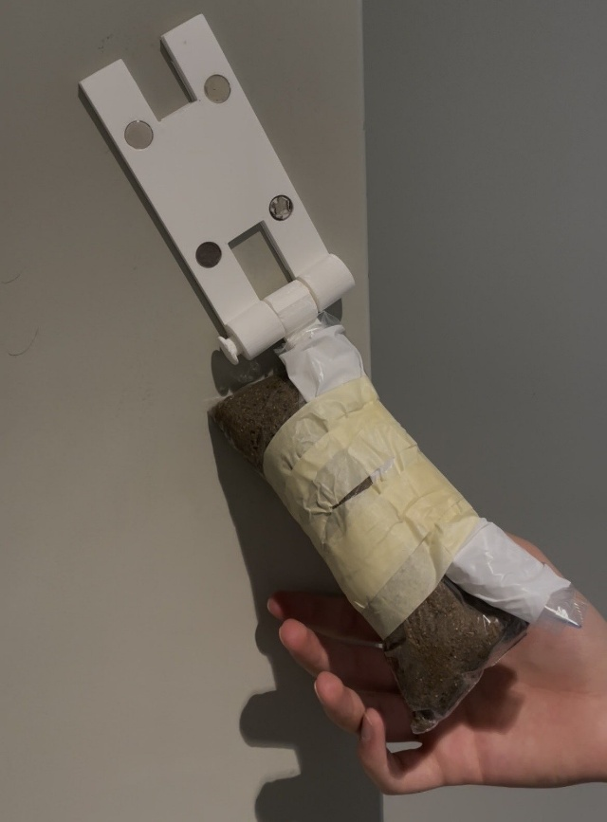
[picture p72: figure]
Afbeelding met muur, vasthouden, persoon, overdekt Door AI gegenereerde inhoud is mogelijk onjuist.

- Kleefgum (Pritt Buddies)

De kleefgum deed zijn werk perfect bij open en gesloten stand van het scharnier. De sterkte van deze kleefgum overtrof onze verwachtingen heel erg. De kleefgum kan wel makkelijker zijn om terug los te maken dan andere verbindingen. De prijs is zeer schappelijk en dus geen probleem.

- Dubbelzijdige plakband

De dubbelzijdige plakband was de makkelijkste manier om het scharnier mooi en recht op te hangen, door het gebruiken van horizontale stroken. De kleefkracht voldeed hier opnieuw aan de eisen en hield het scharnier stevig vast bij open en gesloten stand. De verbinding was echter wel vervelend om los te maken door de grote sterkte van de kleefverbinding. De prijs van een rol dubbelzijdige plakband is zeer schappelijk en is dus ook geen probleem.

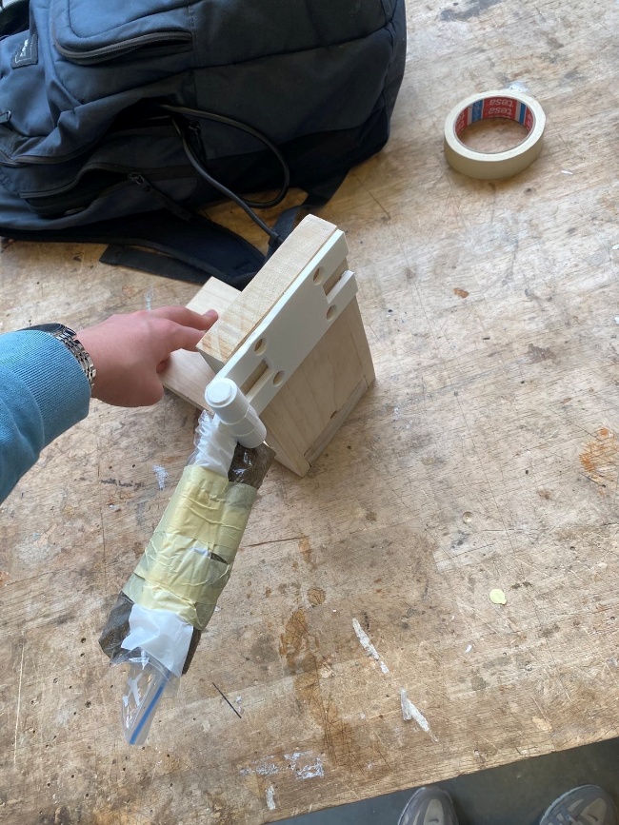
[picture p73: figure]
Afbeelding met persoon, kleding, grond, ambachtsman Door AI gegenereerde inhoud is mogelijk onjuist.
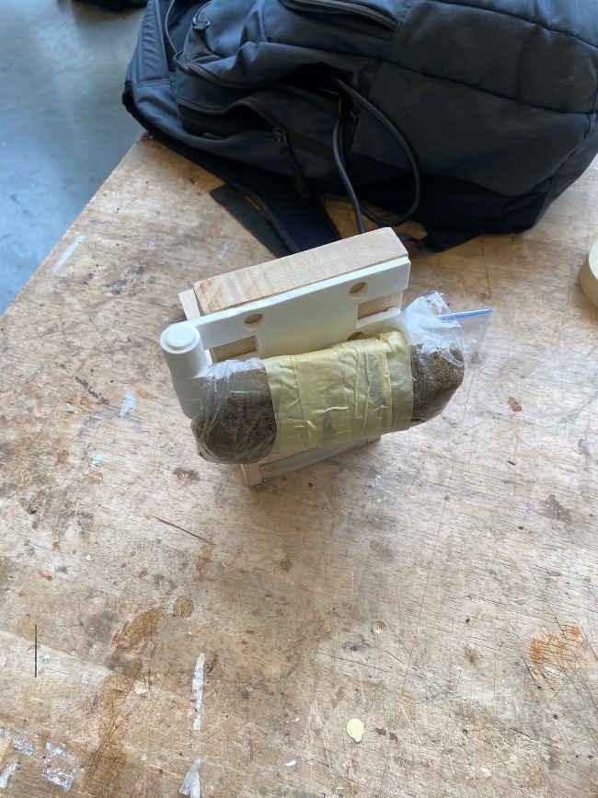
[picture p74: figure]
Afbeelding met grond, schoeisel, gereedschap, vloer Door AI gegenereerde inhoud is mogelijk onjuist.

Conclusies & implicaties

Zowel de dubbelzijdige tape als de kleefgum waren sterke kandidaten om gebruikt te kunnen worden als verbindingstechniek voor de TasteMate. Echter is er gekozen voor de dubbelzijdige tape. Dit doordat de kleefkracht hier toch een stuk groter was en deze verbindingstechniek zorgde voor een heel makkelijke en correcte bevestiging. Het loskrijgen van deze verbinding is van minder belang omdat het de bedoeling is dat de TasteMate voor een lange periodes (jaren) bevestigt blijft.
