LeonDebonne/TasteMate/reports and protocols/User test rapportering wave 2.docx

User test rapportering wave 2

Projectinformatie

Projectnaam: TasteMate

Het doel van dit project is om het gebruik van de koelkast voor blinden en slechtzienden te bevorderen. Tegenwoordig zijn er weinig oplossingen die blinden en slechtzienden toelaat om de koelkast volledig autonoom te gebruiken. Zaken waarmee blinden en slechtzienden moeite mee hebben zijn het vinden van producten en ook de houdbaarheidsdatum aflezen.

Onderzoekers: Leon Debonne (leon.debonne@ugent.be) & Staf Logie (staf.logie@ugent.be (https://d.docs.live.net/fd7d235552eefb0e/Documents/Schooljaar%2025-26/Sem%201/Project%20gebruiksgericht%20ontwerpen/staf.logie@ugent.be)), Studenten industrieel ingenieur: industrieel ontwerpen, 2IO

Doel user tests

Het doel van deze user test is om info te verwerven rondom het interface en de interacties tussen de koelkast en visueel beperkte personen. Met de testen willen we meer zicht krijgen in welke interacties nog niet gecoverd zijn en op welke onze focus misschien te veel ligt. Als laatst dient het om ons probleem volledig te definiëren. Het exploreren van de interacties tussen de visueel beperkte persoon en een begeleider of familielid is hierbij van groot belang.

Rapportering

In welke mate is het interface intuïtief te gebruiken zonder uitleg?

Na een korte voorstelling van het project werden de FigmaMake interfaces getest zonder verdere uitgebreide uitleg over de werking. Voor de meeste testpersonen bleek de algemene werkingswijze van beide interfaces intuïtief. Gebruikers konden vrij snel inschatten welke handelingen mogelijk waren en hoe ze door het interface moesten navigeren. Dit wijst erop dat de basisstructuur en de logica van de interfaces voldoende duidelijk waren. Dit duidt erop dat de interfaces geen complexe leerfase vereisen.

Welk van de twee interfaces werkt het vlotst tijdens het uitvoeren van taken?

Tijdens het uitvoeren van verschillende taken kwamen er duidelijke verschillen naar voren tussen beide interfaces. Interface 1 werd ervaren als efficiënt en eenvoudig, vooral door zijn duidelijke lay-out en rechtlijnige opbouw. Deze eenvoud zorgde ervoor dat doorsnee gebruikers taken snel konden uitvoeren. Bij interface 2 viel vooral de vlotte interactie met de AI-assistent op. De communicatie tussen gebruiker en systeem verliep hier zeer soepel, wat de uitvoering van taken vergemakkelijkte. Beide interfaces boden dus vlotheid, maar elk op z’n eigen manier. Hieruit kunnen we vervolgens een combinatie gaan maken van de meest belangrijke features.

Welke interface-elementen worden spontaan correct gebruikt en welke bekritiseerd?

Bij interface 1 werd de lay-out spontaan correct gebruikt door de testpersonen. De plaatsing van de elementen was duidelijk en zorgde voor een overzichtelijke interactie. Bij interface 2 bleek het opzoeken van verschillende producten intuïtief te verlopen, wat gebruikers toeliet om snel de inventaris te controleren. Het kleurrijke design van interface 2 werd echter minder positief ontvangen. Testpersonen gaven aan dat dit ontwerp niet bijdroeg aan een professionele uitstraling, maar dat contrast voor blinden en slechtzienden inderdaad van groot belang is, maar dat het nu te schreeuwerig overkwam.

Welke functies van het interface zijn essentieel voor een vlotte interactie?

Uit de testresultaten bleek dat een aantal functies noodzakelijk zijn voor een vlotte en zinvolle interactie met het interface. Het kunnen opzoeken van specifieke producten werd als belangrijk ervaren om de inventaris te raadplegen. Daarnaast werd de aanwezigheid van een AI-assistent gezien als een meerwaarde voor de interactie. Ook het scannen van een kassabon bleek een cruciale functie om de inventaris efficiënt te kunnen aanpassen en niet te veel tijd te verliezen. Ook het menu dat verscheen na het toevoegen van de kassabon vonden ze heel goed. Dit was nog een extra check of alles klopte wat de AI erin stook (datums, productnamen). Tot slot werd het automatisch aanmaken van een boodschappenlijst als heel waardevol beschouwd voor een praktisch gebruik van het systeem.

Welke functies blijken overbodig of zorgen voor verwarring?

Niet alle functies binnen de interfaces droegen evenveel bij aan de gebruikservaring. Bij interface 1 werd de functie waarbij de locatie van voeding werd voorgelezen door de AI-assistent als overbodig ervaren. Aangezien producten zich op vaste locaties bevinden, bood deze functie weinig extra meerwaarde. Ook het luidop lezen van alle producten in de frigo sprak de gebruikers niet aan. Ze stellen liever gerichtere vragen dan helemaal luisteren naar een lange lijst producten.

Welke ontwerpkeuzes verklaren de voorkeur voor één interface boven het andere?

De voorkeur voor een van de interfaces werd beïnvloed door verschillende ontwerpkeuzes. Interface 2 werd positief beoordeeld vanwege de vlotte interactie met de AI-assistent en de synchronisatie met een app die samenwerkt met de koelkast. Interface 1 scoorde daarentegen beter op vlak van eenvoud en efficiëntie van de lay-out. Het visuele ontwerp speelde hierbij een belangrijke rol, aangezien het kleurrijke design van interface 2 als minder professioneel werd ervaren.

Welke aanpassingen aan het interface zijn nodig om het gebruik in de praktijk te verbeteren?

Uit de conclusies en implicaties blijkt dat verschillende aanpassingen noodzakelijk zijn om het interface verder te optimaliseren. Het product moet groot genoeg zijn zodat ook slechtziende personen het interface op het scherm kunnen gebruiken. Functieknoppen moeten voorzien zijn van een tactiel element voor snelle herkenning. De knop voor de AI-assistent moet groot en duidelijk herkenbaar zijn. Daarnaast mag het interface niet te ingewikkeld zijn en mogen knoppen die gebruikt worden door visueel beperkte personen niet op het scherm staan. Functies zoals het automatisch aanmaken van een boodschappenlijst, het opzoeken van specifieke producten en het scannen van een kassabon mogen niet ontbreken.
