LeonDebonne/TasteMate/reports and protocols/User tests protocol wave 2.docx

User tests protocol

Projectinformatie

Projectnaam: TasteMate

Het doel van dit project is om het gebruik van de koelkast voor blinden en slechtzienden te bevorderen. Tegenwoordig zijn er weinig oplossingen die blinden en slechtzienden toelaat om de koelkast volledig autonoom te gebruiken. Zaken waarmee blinden en slechtzienden moeite mee hebben zijn het vinden van producten en ook de houdbaarheidsdatum aflezen.

Onderzoekers: Leon Debonne (leon.debonne@ugent.be) & Staf Logie (staf.logie@ugent.be (https://d.docs.live.net/fd7d235552eefb0e/Documents/Schooljaar%2025-26/Sem%201/Project%20gebruiksgericht%20ontwerpen/staf.logie@ugent.be)), Studenten industrieel ingenieur: industrieel ontwerpen, 2IO

Doel user tests

Het doel van deze user test is om info te verwerven rondom het interface en de interacties tussen de koelkast en visueel beperkte personen. Met de testen willen we meer zicht krijgen in welke interacties nog niet gecoverd zijn en op welke onze focus misschien te veel ligt. Als laatst dient het om ons probleem volledig te definiëren. Het exploreren van de interacties tussen de visueel beperkte persoon en een begeleider of familielid is hierbij van groot belang.

Methodes

De verschillende interfaces worden gegeven aan de testpersoon. Dit wordt gedaan zonder verdere uitleg rondom de functies van dit interface. Zo kan de testpersoon het interface gebruiken zonder enige vooroordelen. Via deze test kan er te weten worden gekomen hoe er intuïtief met het interface wordt omgegaan en op welke functies een te grote of te kleine focus staat. Na deze kennismaking met de interfaces wordt er een experiment gedaan volgens de roleplay methode die dan meer de spraak – assistent nabootst. Op het einde wordt nog eens het prototype als conclusie uit wave 1 besproken

Onderzoeksvragen

- Welk interface werkt het vlotste?
- Welke functies zijn essentieel aan het interface?
- Welke functies kunnen weggelaten worden?
- Worden er interacties over het hoofd gezien bij het gebruik van de koelkast?
- Zijn er zaken die nog kunnen toegevoegd worden aan het product? (app?)
- Hoe wordt tegenwoordig het gebruik van de koelkast gemakkelijker gemaakt?
- Zijn er nog andere problemen omtrent voeding?

Respondenten

De respondenten zijn blinde of slechtziende mensen die werken in een organisatie die deze mensen helpen. Door de testen te doen in die organisatie kunnen er ook begeleiders deelnemen aan de test en kan de interacties tussen de persoon met de visuele beperking en de begeleider beter in kaart gebracht worden. Ook worden er mensen betrokken die niet in de omgeving zitten van een visueel beperkte persoon om te testen hoe zij reageren op onze interfaces.

Prototypes en materiaal

- 2 verschillende interfaces in FigmaMake
- Eenvoudig interface ProtoPie voor simulaties
- Prototype conclusie wave 1
- Laptop
- Smartphone
- Plakband

Discussiegids

Deel 1: Inleiding en voorstelling geïnterviewde

Inleiding

Bedankt voor uw deelname aan dit onderzoek

We zullen starten met ons zelf eerst kort voor te stellen.

Wij zijn Leon Debonne en Staf Logie en we studeren aan de universiteit Gent campus Kortrijk met afstudeerrichting industrieel ingenieur industrieel ontwerpen.

Het project waar we momenteel mee bezig zijn heeft als doel het gebruik van de koelkast bevorderen voor blinde en slechtziende personen. Dit wordt gedaan door een add-on te ontwerp die aan de koelkast hangt. Deze kan gebruikt worden door de blinde of slechtziende persoon maar ook door de begeleider.

Uit het vooronderzoek bleek dat de visueel beperkte populatie moeite heeft met het gebruik van de koelkast. Dit vooral met het lokaliseren van de product en de houdbaarheidsdatum weten.

Vandaag willen we eens testen hoe de visueel beperkte populatie en begeleiders te werk gaan met onze prototypes. De focus van deze testen licht vooral rond de functies van ons product en het interface. De feedback op deze prototypes zullen we dan gebruiken voor ons verder onderzoek.

Als laatst willen we ook zeggen dat er geen juiste of foute antwoorden zijn. Het is belangrijke dat u uw oprechte mening en feedback geeft rond onze prototypes. Wees dus zeker niet bang om vragen te stellen of extra uitleg over het prototype. Als u ideeën heeft of dingen ziet die anders/beter kunnen zouden we dit zeer graag horen. We willen ook zeggen dat al uw feedback anoniem gebruikt zal worden in het verdere verloop van het project. Hiervoor hebben we een INFORMED CONSENT die u moet ondertekenen.

Voorstelling

Vooraleer we beginnen met de testen willen we wat meer zicht in de persoon die voor ons zit.

- Kunt u ons iets meer vertellen over jezelf?
  - Wat doe u in uw vrije tijd?
- Hoe zou u uw visuele beperking beschrijven?
- In welke mate gaat u zelfstandig door het leven?

Deel 2: Noden en verwachtingen

Vooraleer we beginnen aan de testen zouden we eerst enkele vragen stellen.

- Kunt u ons eens snel het proces samenvatten van het eten gaan kopen tot het consumeren zelf?
- Zijn er hier problemen die misschien op voorhand voorkomen kunnen worden?

Blinde/slechtziende:

- Heeft u vaak problemen bij het gebruik van de koelkast?
- Kunt u eens deze problemen specifiëren?
- Hoe lost u dit probleem dan op?

Begeleider:

- Moet u vaak helpen bij het gebruik van de koelkast?
- Hoe wordt er dan geholpen?

We zouden ook graag nog eens ons project in meer detail voorstellen.

Met ons project willen we het gebruik van de koelkast voor blinden en slechtzienden volledig autonoom maken. Het is de bedoeling om een product te ontwerpen die bevestigd kan worden aan de koelkast. Dit product weet hoe de koelkast eruit ziet en waar bepaalde etenswaren liggen. Deze informatie wordt ingevoerd door een persoon uit de omgeving van de blinde of slechtziende persoon. Hierna kan er worden gecommuniceerd met het product via een spraak-assistent die de nodige hulp kan bieden.

- Wat is uw eerste reactie op dit idee?
- Wat vindt u goed/minder goed?
- Waar stelt u eventueel nog vragen bij? Wat is onduidelijk?
- Hoe verwacht u dat dit product eruit ziet?
- Welke functies verwacht u dat er in dit product zitten?

Deel 3: Simulatie van de oplossing – unguided

Beide interfaces worden eens voorgelegd zonder randinformatie. Zo kan gezien worden hoe de testpersonen er uit nature mee opgaan.

Als volgende deel zullen we het gebruiksproces een simuleren om de werking duidelijker te maken. Het prototype met plakband vastmaken aan de koelkast of een kast.

Deel 4: Evaluatie en acceptatie

Evaluatie

- In het algemeen, wat vindt u van dit idee?
- Wat vindt u er goed aan?
- Wat vindt u er eventueel minder goed aan?
- Wat zou u zelf aanpassen mocht u kunnen kiezen?
- Wat vond u van het eerste interface?
- Wat was goed?
- Wat was minder goed?
- Wat vond u van het tweede interface?
- Wat was goed?
- Wat was minder goed?
  - Wat vond u van het prototype?
- Wat was goed?
- Wat was minder goed?
  - Naar welk interface gaat uw voorkeur?
- Waarom?
  - Zijn er ander problemen die zouden kunnen worden opgelost met het product?
  - Zijn er interacties tussen de visueel beperkte persoon en de koelkast of de begeleider/familielid die over het hoofd worden gezien?
  - Ziet u nog een mogelijkheid voor een uitbreiding via een app?

Acceptatie

Ten slotte willen we nog weten ofdat u dit product zou gebruiken.

- Zou u dit product gebruiken?
  - In welke context?
  - Wanneer?
  - Wat zijn de mogelijke barrières? Waarom zou u het misschien niet gebruiken?
- Wat zijn de grootste redenen voor dit antwoord?
  - Hoe kan dit antwoord verandert worden?

Achteraf

Deelnemer bedanken en vragen om wat foto’s te nemen met de producten.
