LeonDebonne/TasteMate/reports and protocols/Benchmarking protocol.docx

Benchmarking protocol

Projectinformatie

Projectnaam: Spatial Experiences for Visually Impaired populations

Het doel van dit project is om mensen met een visuele beperking te helpen met een product waarmee hun ruimtelijke ervaring kan bevorderd worden.

Blinden en slechtzienden komen dagelijks in contact met hordes doordat de samenleving niet is afgesteld op hun noden. Door deze problemen aan te pakken kunnen we de wereld meer toegankelijk maken voor alle mensen.

Onderzoeker: Leon Debonne (leon.debonne@ugent.be), Student industrieel ingenieur: industrieel ontwerpen, 2IO

Doel benchmarking

Het doel van benchmarking is de markt te gaan scopen naar bestaande oplossingen. Zo kan er een beeld gemaakt worden van hoe de markt georiënteerd is en waar er mogelijke gaps zitten waar we kunnen op gaan inspelen.

Bij het ontwerpen van een product moet niet altijd het warm water opnieuw uitgevonden worden, daarom is het interessant om de oplossingen van andere bedrijven in overweging te nemen of verder te bouwen op iets dat al bestaat.

Door ons product te gaan vergelijken met de concurrentie kan er gevalideerd worden of het product voldoet aan de vooropgestelde eisen.

Onderzoeksvragen

- Hoe is de markt georiënteerd?
- Welke technologieën worden gebruikt?
- Wat is de gemiddelde kostprijs van dergelijke hulpmiddelen?
- Welke producten doen het goed op de markt en waarom?

Producten/Webpagina’s

De volgende producten zijn gebruikt voor het opstellen van een benchmarking:

- Smartcane 2 https://wewalk.io/en/product/wewalk-smart-cane-2-black/
- The vector https://www.makesensetechnology.com/product
- naviBelt https://feelspace.de/en/#bereit
- Lumen glasses https://www.dotlumen.com/glasses
- EMVI-app https://www.emvi.ai/
- Aisee https://aisee.ai/
- Glidance https://glidance.io/
- NOA https://biped.ai/nl/
- Safestep Niet terug gevonden.
- Hoople https://accessdirect.org/products/hoople-training-cane-xs-85mm
