LeonDebonne/TasteMate/(commit log)

2025-12-14 links bom
2025-12-16 fotos prototypes
2026-01-15 foto prototypes
2026-03-03 bom en doelstelling
2026-03-17 CAD bestanden
    [Scharnier.prt, TasteMate assy.prt, TasteMate.prt]
2026-03-24 develop 2
    [TasteMate.prt]
2026-04-02 materialen en methoden
2026-04-06 materialen en methodiek
2026-04-06 excel touchpoints
    [Touchpoints.xlsx]
2026-04-06 verwijderen arduino deel develop
2026-05-04 variaty prototypes
    [Tactiele_Knoppen.prt, Vormen.prt]
